MkLJensen/iFollow/RapportBilag/Proces/Trello/Research.PNG

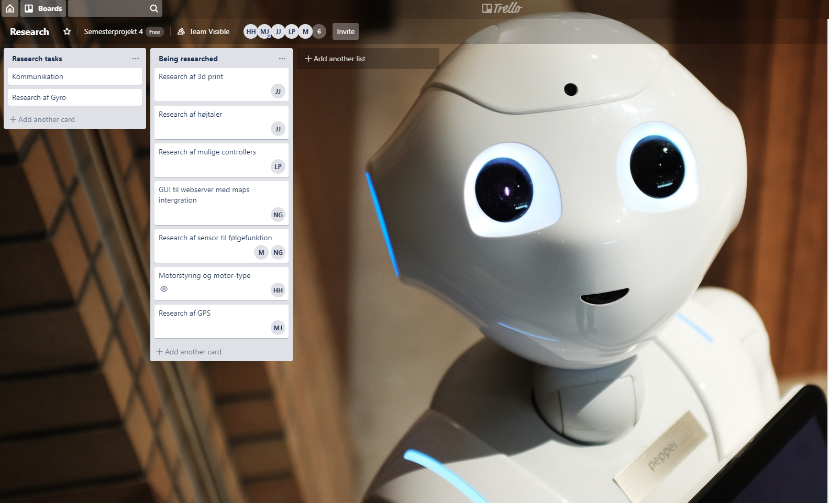
RapportBilag/Proces/Trello/Research.PNG
