MkLJensen/iFollow/RapportBilag/Proces/Trello/Sprint3.PNG

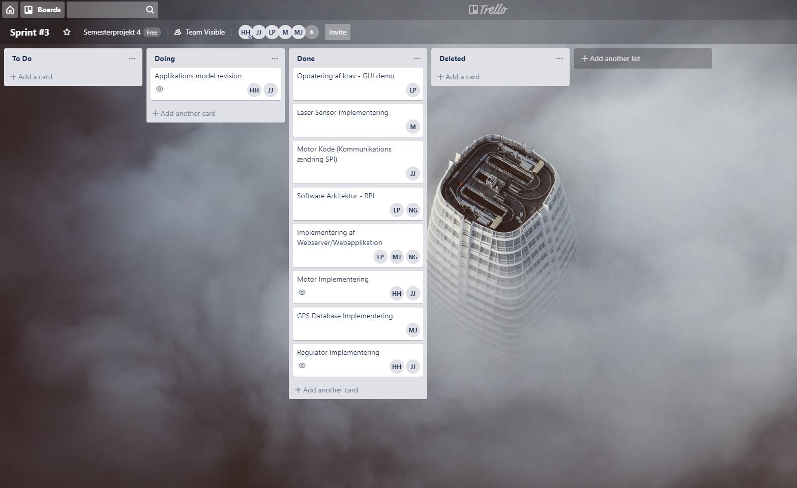
RapportBilag/Proces/Trello/Sprint3.PNG
