MkLJensen/iFollow/README.md

# iFollow - the spiciest memelord of a robot
