MkLJensen/iFollow/Krav og Design/Rigt Billede.pptx

Semesterprojekt 4 - iFollow

Interface

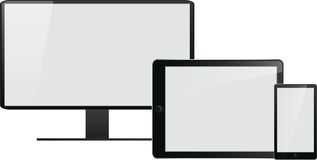
[picture p3: figure]
Billedresultat for pc / mobile

Web – Server (Wi-Fi)

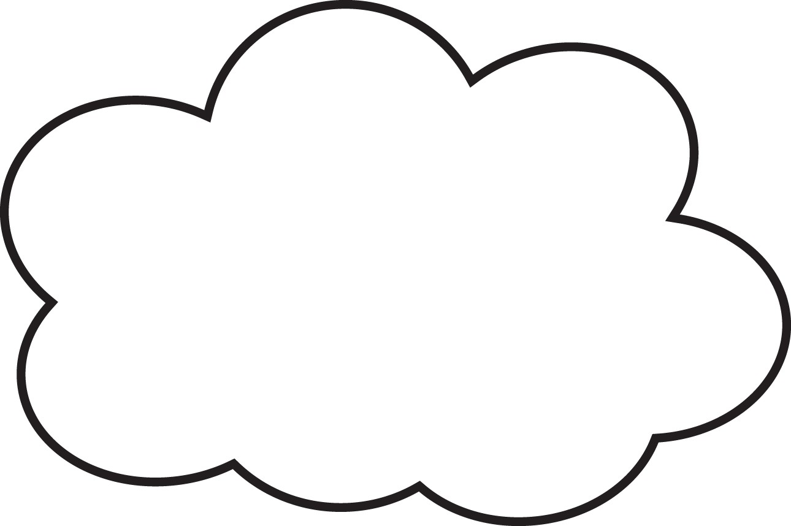
[picture p4: figure]
Billedresultat for cloud sketch

Communicating With

Wi-Fi

RPi

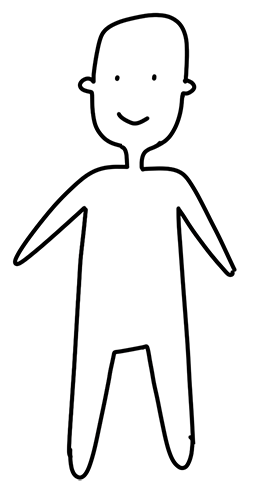
[picture p5: figure]
Billedresultat for person sketch

User

Interacts
with

Follow

Microcontroller

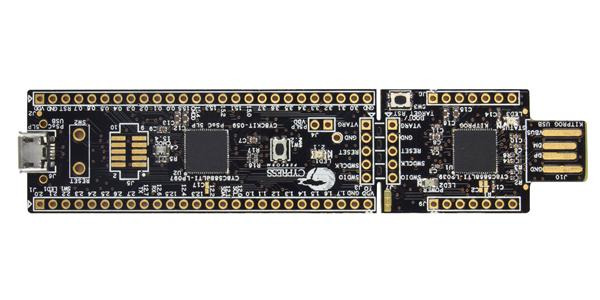
[picture p6: figure]
Billedresultat for psoc 5
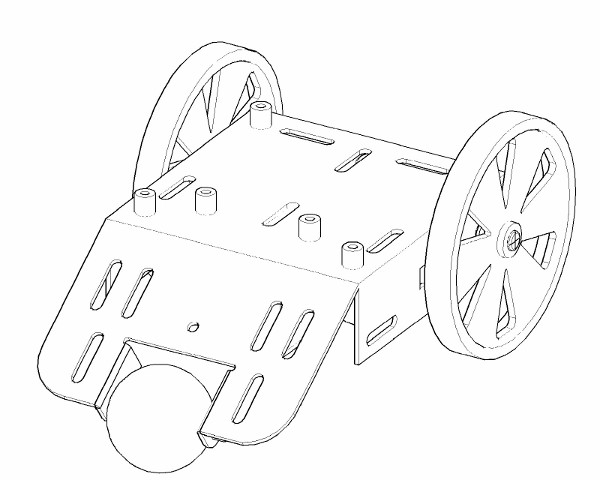
[picture p7: figure]
Billedresultat for 3 wheel robot drawing

Robot

Controlled by

Using

Controlling

Using

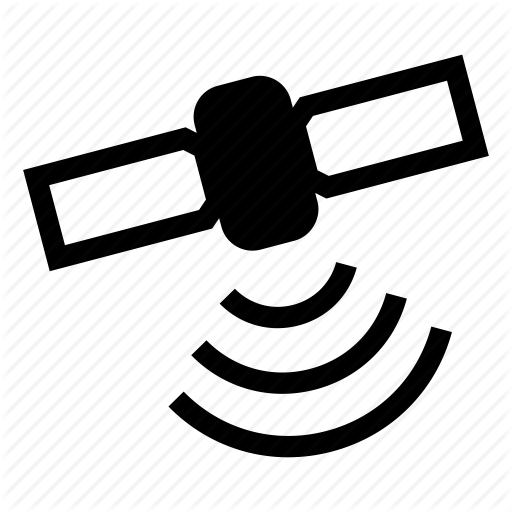
[picture p8: figure]
Billedresultat for gps icon transparent

GPS

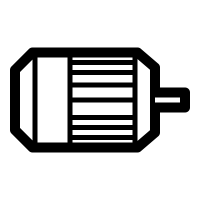
[picture p9: figure]
Billedresultat for motor icon

Motor

Sensor

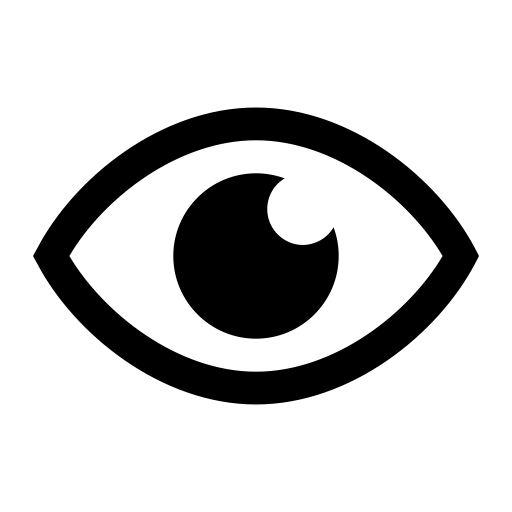
[picture p10: figure]
Billedresultat for eye icon
