MkLJensen/iFollow/Software/PSOC/ToF/Design01.cydsn/Design01_timing.html

# Static Timing Analysis

Project : | Design01
Build Time : | 05/01/19 14:06:55
Device : | CY8C5888LTI-LP097
Temperature : | -40C - 85/125C
VDDA : | 5.00
VDDABUF : | 5.00
VDDD : | 5.00
VDDIO0 : | 5.00
VDDIO1 : | 5.00
VDDIO2 : | 5.00
VDDIO3 : | 5.00
VUSB : | 5.00
Voltage : | 5.0

Expand All | Collapse All | Show All Paths | Hide All Paths

+ Timing Violation Section

No Timing Violations

+ Clock Summary Section

Clock | Domain | Nominal Frequency | Required Frequency | Maximum Frequency | Violation
CyILO | CyILO | 1.000 kHz | 1.000 kHz | N/A
CyIMO | CyIMO | 3.000 MHz | 3.000 MHz | N/A
CyMASTER_CLK | CyMASTER_CLK | 24.000 MHz | 24.000 MHz | N/A
CyBUS_CLK | CyMASTER_CLK | 24.000 MHz | 24.000 MHz | 61.725 MHz
SPIS_IntClock | CyMASTER_CLK | 4.000 MHz | 4.000 MHz | 63.167 MHz
UART_1_IntClock | CyMASTER_CLK | 461.538 kHz | 461.538 kHz | 45.043 MHz
CyPLL_OUT | CyPLL_OUT | 24.000 MHz | 24.000 MHz | N/A
sclk(0)_PAD | sclk(0)_PAD | UNKNOWN | UNKNOWN | 46.079 MHz

+ Register to Register Section

+ Setup Subsection

+ Source Clock : CyBUS_CLK : Positive edge(Required Frequency 24 MHz)

+ Destination Clock : UART_1_IntClock : Positive edge(Required Frequency 461.538 kHz)

Path Delay Requirement : 41.6667ns(24 MHz)

Affects clock : CyMASTER_CLK

Source | Destination | FMax | Delay (ns) | Slack (ns) | Violation
Rx_1(0)/fb | \UART_1:BUART:sRX:RxShifter:u0\/route_si | 61.725 MHz | 16.201 | 25.466

Type | Location | Fanout | Instance/Net | Source | Dest | Delay (ns)
iocell6 | P12[6] | 1 | Rx_1(0) | Rx_1(0)/in_clock | Rx_1(0)/fb | 2.009
Route | | 1 | Net_39 | Rx_1(0)/fb | \UART_1:BUART:rx_postpoll\/main_1 | 5.123
macrocell15 | U(0,0) | 1 | \UART_1:BUART:rx_postpoll\ | \UART_1:BUART:rx_postpoll\/main_1 | \UART_1:BUART:rx_postpoll\/q | 3.350
Route | | 1 | \UART_1:BUART:rx_postpoll\ | \UART_1:BUART:rx_postpoll\/q | \UART_1:BUART:sRX:RxShifter:u0\/route_si | 2.249
datapathcell4 | U(0,0) | 1 | \UART_1:BUART:sRX:RxShifter:u0\ | | SETUP | 3.470
Clock | | | | | Skew | 0.000
Rx_1(0)/fb | \UART_1:BUART:pollcount_1\/main_3 | 76.899 MHz | 13.004 | 28.663

Type | Location | Fanout | Instance/Net | Source | Dest | Delay (ns)
iocell6 | P12[6] | 1 | Rx_1(0) | Rx_1(0)/in_clock | Rx_1(0)/fb | 2.009
Route | | 1 | Net_39 | Rx_1(0)/fb | \UART_1:BUART:pollcount_1\/main_3 | 7.485
macrocell33 | U(0,1) | 1 | \UART_1:BUART:pollcount_1\ | | SETUP | 3.510
Clock | | | | | Skew | 0.000
Rx_1(0)/fb | \UART_1:BUART:pollcount_0\/main_2 | 80.308 MHz | 12.452 | 29.215

Type | Location | Fanout | Instance/Net | Source | Dest | Delay (ns)
iocell6 | P12[6] | 1 | Rx_1(0) | Rx_1(0)/in_clock | Rx_1(0)/fb | 2.009
Route | | 1 | Net_39 | Rx_1(0)/fb | \UART_1:BUART:pollcount_0\/main_2 | 6.933
macrocell34 | U(0,1) | 1 | \UART_1:BUART:pollcount_0\ | | SETUP | 3.510
Clock | | | | | Skew | 0.000
Rx_1(0)/fb | \UART_1:BUART:rx_state_2\/main_8 | 93.870 MHz | 10.653 | 31.014

Type | Location | Fanout | Instance/Net | Source | Dest | Delay (ns)
iocell6 | P12[6] | 1 | Rx_1(0) | Rx_1(0)/in_clock | Rx_1(0)/fb | 2.009
Route | | 1 | Net_39 | Rx_1(0)/fb | \UART_1:BUART:rx_state_2\/main_8 | 5.134
macrocell30 | U(0,0) | 1 | \UART_1:BUART:rx_state_2\ | | SETUP | 3.510
Clock | | | | | Skew | 0.000
Rx_1(0)/fb | \UART_1:BUART:rx_status_3\/main_6 | 93.870 MHz | 10.653 | 31.014

Type | Location | Fanout | Instance/Net | Source | Dest | Delay (ns)
iocell6 | P12[6] | 1 | Rx_1(0) | Rx_1(0)/in_clock | Rx_1(0)/fb | 2.009
Route | | 1 | Net_39 | Rx_1(0)/fb | \UART_1:BUART:rx_status_3\/main_6 | 5.134
macrocell35 | U(0,0) | 1 | \UART_1:BUART:rx_status_3\ | | SETUP | 3.510
Clock | | | | | Skew | 0.000
Rx_1(0)/fb | \UART_1:BUART:rx_state_0\/main_9 | 93.967 MHz | 10.642 | 31.025

Type | Location | Fanout | Instance/Net | Source | Dest | Delay (ns)
iocell6 | P12[6] | 1 | Rx_1(0) | Rx_1(0)/in_clock | Rx_1(0)/fb | 2.009
Route | | 1 | Net_39 | Rx_1(0)/fb | \UART_1:BUART:rx_state_0\/main_9 | 5.123
macrocell27 | U(0,0) | 1 | \UART_1:BUART:rx_state_0\ | | SETUP | 3.510
Clock | | | | | Skew | 0.000
Rx_1(0)/fb | \UART_1:BUART:rx_last\/main_0 | 93.967 MHz | 10.642 | 31.025

Type | Location | Fanout | Instance/Net | Source | Dest | Delay (ns)
iocell6 | P12[6] | 1 | Rx_1(0) | Rx_1(0)/in_clock | Rx_1(0)/fb | 2.009
Route | | 1 | Net_39 | Rx_1(0)/fb | \UART_1:BUART:rx_last\/main_0 | 5.123
macrocell36 | U(0,0) | 1 | \UART_1:BUART:rx_last\ | | SETUP | 3.510
Clock | | | | | Skew | 0.000

+ Source Clock : SPIS_IntClock : Positive edge(Required Frequency 4 MHz)

+ Destination Clock : SPIS_IntClock : Positive edge(Required Frequency 4 MHz)

Path Delay Requirement : 250ns(4 MHz)

Source | Destination | FMax | Delay (ns) | Slack (ns) | Violation
\SPIS:BSPIS:sync_2\/out | \SPIS:BSPIS:TxStsReg\/status_0 | 63.167 MHz | 15.831 | 234.169

Type | Location | Fanout | Instance/Net | Source | Dest | Delay (ns)
synccell | U(1,0) | 1 | \SPIS:BSPIS:sync_2\ | \SPIS:BSPIS:sync_2\/clock | \SPIS:BSPIS:sync_2\/out | 1.020
Route | | 1 | \SPIS:BSPIS:miso_tx_empty_reg_fin\ | \SPIS:BSPIS:sync_2\/out | \SPIS:BSPIS:tx_status_0\/main_2 | 5.713
macrocell7 | U(1,3) | 1 | \SPIS:BSPIS:tx_status_0\ | \SPIS:BSPIS:tx_status_0\/main_2 | \SPIS:BSPIS:tx_status_0\/q | 3.350
Route | | 1 | \SPIS:BSPIS:tx_status_0\ | \SPIS:BSPIS:tx_status_0\/q | \SPIS:BSPIS:TxStsReg\/status_0 | 5.248
statusicell1 | U(1,1) | 1 | \SPIS:BSPIS:TxStsReg\ | | SETUP | 0.500
Clock | | | | | Skew | 0.000
\SPIS:BSPIS:dpcounter_one_reg\/q | \SPIS:BSPIS:TxStsReg\/status_0 | 68.101 MHz | 14.684 | 235.316

Type | Location | Fanout | Instance/Net | Source | Dest | Delay (ns)
macrocell18 | U(1,0) | 1 | \SPIS:BSPIS:dpcounter_one_reg\ | \SPIS:BSPIS:dpcounter_one_reg\/clock_0 | \SPIS:BSPIS:dpcounter_one_reg\/q | 1.250
Route | | 1 | \SPIS:BSPIS:dpcounter_one_reg\ | \SPIS:BSPIS:dpcounter_one_reg\/q | \SPIS:BSPIS:tx_status_0\/main_1 | 4.336
macrocell7 | U(1,3) | 1 | \SPIS:BSPIS:tx_status_0\ | \SPIS:BSPIS:tx_status_0\/main_1 | \SPIS:BSPIS:tx_status_0\/q | 3.350
Route | | 1 | \SPIS:BSPIS:tx_status_0\ | \SPIS:BSPIS:tx_status_0\/q | \SPIS:BSPIS:TxStsReg\/status_0 | 5.248
statusicell1 | U(1,1) | 1 | \SPIS:BSPIS:TxStsReg\ | | SETUP | 0.500
Clock | | | | | Skew | 0.000
\SPIS:BSPIS:dpcounter_one_reg\/q | \SPIS:BSPIS:TxStsReg\/status_6 | 68.185 MHz | 14.666 | 235.334

Type | Location | Fanout | Instance/Net | Source | Dest | Delay (ns)
macrocell18 | U(1,0) | 1 | \SPIS:BSPIS:dpcounter_one_reg\ | \SPIS:BSPIS:dpcounter_one_reg\/clock_0 | \SPIS:BSPIS:dpcounter_one_reg\/q | 1.250
Route | | 1 | \SPIS:BSPIS:dpcounter_one_reg\ | \SPIS:BSPIS:dpcounter_one_reg\/q | \SPIS:BSPIS:byte_complete\/main_1 | 4.336
macrocell3 | U(1,3) | 1 | \SPIS:BSPIS:byte_complete\ | \SPIS:BSPIS:byte_complete\/main_1 | \SPIS:BSPIS:byte_complete\/q | 3.350
Route | | 1 | \SPIS:BSPIS:byte_complete\ | \SPIS:BSPIS:byte_complete\/q | \SPIS:BSPIS:TxStsReg\/status_6 | 5.230
statusicell1 | U(1,1) | 1 | \SPIS:BSPIS:TxStsReg\ | | SETUP | 0.500
Clock | | | | | Skew | 0.000
\SPIS:BSPIS:sync_1\/out | \SPIS:BSPIS:TxStsReg\/status_0 | 80.483 MHz | 12.425 | 237.575

Type | Location | Fanout | Instance/Net | Source | Dest | Delay (ns)
synccell | U(1,3) | 1 | \SPIS:BSPIS:sync_1\ | \SPIS:BSPIS:sync_1\/clock | \SPIS:BSPIS:sync_1\/out | 1.020
Route | | 1 | \SPIS:BSPIS:dpcounter_one_fin\ | \SPIS:BSPIS:sync_1\/out | \SPIS:BSPIS:tx_status_0\/main_0 | 2.307
macrocell7 | U(1,3) | 1 | \SPIS:BSPIS:tx_status_0\ | \SPIS:BSPIS:tx_status_0\/main_0 | \SPIS:BSPIS:tx_status_0\/q | 3.350
Route | | 1 | \SPIS:BSPIS:tx_status_0\ | \SPIS:BSPIS:tx_status_0\/q | \SPIS:BSPIS:TxStsReg\/status_0 | 5.248
statusicell1 | U(1,1) | 1 | \SPIS:BSPIS:TxStsReg\ | | SETUP | 0.500
Clock | | | | | Skew | 0.000
\SPIS:BSPIS:sync_1\/out | \SPIS:BSPIS:TxStsReg\/status_6 | 80.600 MHz | 12.407 | 237.593

Type | Location | Fanout | Instance/Net | Source | Dest | Delay (ns)
synccell | U(1,3) | 1 | \SPIS:BSPIS:sync_1\ | \SPIS:BSPIS:sync_1\/clock | \SPIS:BSPIS:sync_1\/out | 1.020
Route | | 1 | \SPIS:BSPIS:dpcounter_one_fin\ | \SPIS:BSPIS:sync_1\/out | \SPIS:BSPIS:byte_complete\/main_0 | 2.307
macrocell3 | U(1,3) | 1 | \SPIS:BSPIS:byte_complete\ | \SPIS:BSPIS:byte_complete\/main_0 | \SPIS:BSPIS:byte_complete\/q | 3.350
Route | | 1 | \SPIS:BSPIS:byte_complete\ | \SPIS:BSPIS:byte_complete\/q | \SPIS:BSPIS:TxStsReg\/status_6 | 5.230
statusicell1 | U(1,1) | 1 | \SPIS:BSPIS:TxStsReg\ | | SETUP | 0.500
Clock | | | | | Skew | 0.000
\SPIS:BSPIS:sync_3\/out | \SPIS:BSPIS:RxStsReg\/status_5 | 85.281 MHz | 11.726 | 238.274

Type | Location | Fanout | Instance/Net | Source | Dest | Delay (ns)
synccell | U(1,3) | 1 | \SPIS:BSPIS:sync_3\ | \SPIS:BSPIS:sync_3\/clock | \SPIS:BSPIS:sync_3\/out | 1.020
Route | | 1 | \SPIS:BSPIS:mosi_buf_overrun_reg\ | \SPIS:BSPIS:sync_3\/out | \SPIS:BSPIS:rx_buf_overrun\/main_0 | 4.535
macrocell4 | U(1,3) | 1 | \SPIS:BSPIS:rx_buf_overrun\ | \SPIS:BSPIS:rx_buf_overrun\/main_0 | \SPIS:BSPIS:rx_buf_overrun\/q | 3.350
Route | | 1 | \SPIS:BSPIS:rx_buf_overrun\ | \SPIS:BSPIS:rx_buf_overrun\/q | \SPIS:BSPIS:RxStsReg\/status_5 | 2.321
statusicell2 | U(0,3) | 1 | \SPIS:BSPIS:RxStsReg\ | | SETUP | 0.500
Clock | | | | | Skew | 0.000
\SPIS:BSPIS:mosi_buf_overrun_fin\/q | \SPIS:BSPIS:RxStsReg\/status_5 | 96.890 MHz | 10.321 | 239.679

Type | Location | Fanout | Instance/Net | Source | Dest | Delay (ns)
macrocell19 | U(1,2) | 1 | \SPIS:BSPIS:mosi_buf_overrun_fin\ | \SPIS:BSPIS:mosi_buf_overrun_fin\/clock_0 | \SPIS:BSPIS:mosi_buf_overrun_fin\/q | 1.250
Route | | 1 | \SPIS:BSPIS:mosi_buf_overrun_fin\ | \SPIS:BSPIS:mosi_buf_overrun_fin\/q | \SPIS:BSPIS:rx_buf_overrun\/main_1 | 2.900
macrocell4 | U(1,3) | 1 | \SPIS:BSPIS:rx_buf_overrun\ | \SPIS:BSPIS:rx_buf_overrun\/main_1 | \SPIS:BSPIS:rx_buf_overrun\/q | 3.350
Route | | 1 | \SPIS:BSPIS:rx_buf_overrun\ | \SPIS:BSPIS:rx_buf_overrun\/q | \SPIS:BSPIS:RxStsReg\/status_5 | 2.321
statusicell2 | U(0,3) | 1 | \SPIS:BSPIS:RxStsReg\ | | SETUP | 0.500
Clock | | | | | Skew | 0.000
\SPIS:BSPIS:sync_1\/out | \SPIS:BSPIS:dpcounter_one_reg\/main_0 | 108.401 MHz | 9.225 | 240.775

Type | Location | Fanout | Instance/Net | Source | Dest | Delay (ns)
synccell | U(1,3) | 1 | \SPIS:BSPIS:sync_1\ | \SPIS:BSPIS:sync_1\/clock | \SPIS:BSPIS:sync_1\/out | 1.020
Route | | 1 | \SPIS:BSPIS:dpcounter_one_fin\ | \SPIS:BSPIS:sync_1\/out | \SPIS:BSPIS:dpcounter_one_reg\/main_0 | 4.695
macrocell18 | U(1,0) | 1 | \SPIS:BSPIS:dpcounter_one_reg\ | | SETUP | 3.510
Clock | | | | | Skew | 0.000
\SPIS:BSPIS:sync_3\/out | \SPIS:BSPIS:mosi_buf_overrun_fin\/main_0 | 118.399 MHz | 8.446 | 241.554

Type | Location | Fanout | Instance/Net | Source | Dest | Delay (ns)
synccell | U(1,3) | 1 | \SPIS:BSPIS:sync_3\ | \SPIS:BSPIS:sync_3\/clock | \SPIS:BSPIS:sync_3\/out | 1.020
Route | | 1 | \SPIS:BSPIS:mosi_buf_overrun_reg\ | \SPIS:BSPIS:sync_3\/out | \SPIS:BSPIS:mosi_buf_overrun_fin\/main_0 | 3.916
macrocell19 | U(1,2) | 1 | \SPIS:BSPIS:mosi_buf_overrun_fin\ | | SETUP | 3.510
Clock | | | | | Skew | 0.000

+ Source Clock : UART_1_IntClock : Positive edge(Required Frequency 461.538 kHz)

+ Destination Clock : UART_1_IntClock : Positive edge(Required Frequency 461.538 kHz)

Path Delay Requirement : 2166.67ns(461.538 kHz)

Source | Destination | FMax | Delay (ns) | Slack (ns) | Violation
\UART_1:BUART:rx_state_0\/q | \UART_1:BUART:sRX:RxBitCounter\/load | 45.043 MHz | 22.201 | 2144.466

Type | Location | Fanout | Instance/Net | Source | Dest | Delay (ns)
macrocell27 | U(0,0) | 1 | \UART_1:BUART:rx_state_0\ | \UART_1:BUART:rx_state_0\/clock_0 | \UART_1:BUART:rx_state_0\/q | 1.250
Route | | 1 | \UART_1:BUART:rx_state_0\ | \UART_1:BUART:rx_state_0\/q | \UART_1:BUART:rx_counter_load\/main_1 | 7.882
macrocell14 | U(0,3) | 1 | \UART_1:BUART:rx_counter_load\ | \UART_1:BUART:rx_counter_load\/main_1 | \UART_1:BUART:rx_counter_load\/q | 3.350
Route | | 1 | \UART_1:BUART:rx_counter_load\ | \UART_1:BUART:rx_counter_load\/q | \UART_1:BUART:sRX:RxBitCounter\/load | 4.359
count7cell | U(0,0) | 1 | \UART_1:BUART:sRX:RxBitCounter\ | | SETUP | 5.360
Clock | | | | | Skew | 0.000
\UART_1:BUART:rx_state_2\/q | \UART_1:BUART:sRX:RxBitCounter\/load | 48.480 MHz | 20.627 | 2146.040

Type | Location | Fanout | Instance/Net | Source | Dest | Delay (ns)
macrocell30 | U(0,0) | 1 | \UART_1:BUART:rx_state_2\ | \UART_1:BUART:rx_state_2\/clock_0 | \UART_1:BUART:rx_state_2\/q | 1.250
Route | | 1 | \UART_1:BUART:rx_state_2\ | \UART_1:BUART:rx_state_2\/q | \UART_1:BUART:rx_counter_load\/main_3 | 6.308
macrocell14 | U(0,3) | 1 | \UART_1:BUART:rx_counter_load\ | \UART_1:BUART:rx_counter_load\/main_3 | \UART_1:BUART:rx_counter_load\/q | 3.350
Route | | 1 | \UART_1:BUART:rx_counter_load\ | \UART_1:BUART:rx_counter_load\/q | \UART_1:BUART:sRX:RxBitCounter\/load | 4.359
count7cell | U(0,0) | 1 | \UART_1:BUART:sRX:RxBitCounter\ | | SETUP | 5.360
Clock | | | | | Skew | 0.000
\UART_1:BUART:tx_ctrl_mark_last\/q | \UART_1:BUART:sRX:RxBitCounter\/load | 50.587 MHz | 19.768 | 2146.899

Type | Location | Fanout | Instance/Net | Source | Dest | Delay (ns)
macrocell26 | U(0,1) | 1 | \UART_1:BUART:tx_ctrl_mark_last\ | \UART_1:BUART:tx_ctrl_mark_last\/clock_0 | \UART_1:BUART:tx_ctrl_mark_last\/q | 1.250
Route | | 1 | \UART_1:BUART:tx_ctrl_mark_last\ | \UART_1:BUART:tx_ctrl_mark_last\/q | \UART_1:BUART:rx_counter_load\/main_0 | 5.449
macrocell14 | U(0,3) | 1 | \UART_1:BUART:rx_counter_load\ | \UART_1:BUART:rx_counter_load\/main_0 | \UART_1:BUART:rx_counter_load\/q | 3.350
Route | | 1 | \UART_1:BUART:rx_counter_load\ | \UART_1:BUART:rx_counter_load\/q | \UART_1:BUART:sRX:RxBitCounter\/load | 4.359
count7cell | U(0,0) | 1 | \UART_1:BUART:sRX:RxBitCounter\ | | SETUP | 5.360
Clock | | | | | Skew | 0.000
\UART_1:BUART:sTX:TxShifter:u0\/f0_blk_stat_comb | \UART_1:BUART:sTX:TxSts\/status_0 | 53.772 MHz | 18.597 | 2148.070

Type | Location | Fanout | Instance/Net | Source | Dest | Delay (ns)
datapathcell2 | U(0,3) | 1 | \UART_1:BUART:sTX:TxShifter:u0\ | \UART_1:BUART:sTX:TxShifter:u0\/clock | \UART_1:BUART:sTX:TxShifter:u0\/f0_blk_stat_comb | 3.580
Route | | 1 | \UART_1:BUART:tx_fifo_empty\ | \UART_1:BUART:sTX:TxShifter:u0\/f0_blk_stat_comb | \UART_1:BUART:tx_status_0\/main_3 | 5.342
macrocell12 | U(0,1) | 1 | \UART_1:BUART:tx_status_0\ | \UART_1:BUART:tx_status_0\/main_3 | \UART_1:BUART:tx_status_0\/q | 3.350
Route | | 1 | \UART_1:BUART:tx_status_0\ | \UART_1:BUART:tx_status_0\/q | \UART_1:BUART:sTX:TxSts\/status_0 | 5.825
statusicell3 | U(0,2) | 1 | \UART_1:BUART:sTX:TxSts\ | | SETUP | 0.500
Clock | | | | | Skew | 0.000
\UART_1:BUART:rx_state_3\/q | \UART_1:BUART:sRX:RxBitCounter\/load | 54.431 MHz | 18.372 | 2148.295

Type | Location | Fanout | Instance/Net | Source | Dest | Delay (ns)
macrocell29 | U(1,3) | 1 | \UART_1:BUART:rx_state_3\ | \UART_1:BUART:rx_state_3\/clock_0 | \UART_1:BUART:rx_state_3\/q | 1.250
Route | | 1 | \UART_1:BUART:rx_state_3\ | \UART_1:BUART:rx_state_3\/q | \UART_1:BUART:rx_counter_load\/main_2 | 4.053
macrocell14 | U(0,3) | 1 | \UART_1:BUART:rx_counter_load\ | \UART_1:BUART:rx_counter_load\/main_2 | \UART_1:BUART:rx_counter_load\/q | 3.350
Route | | 1 | \UART_1:BUART:rx_counter_load\ | \UART_1:BUART:rx_counter_load\/q | \UART_1:BUART:sRX:RxBitCounter\/load | 4.359
count7cell | U(0,0) | 1 | \UART_1:BUART:sRX:RxBitCounter\ | | SETUP | 5.360
Clock | | | | | Skew | 0.000
\UART_1:BUART:tx_state_2\/q | \UART_1:BUART:sTX:sCLOCK:TxBitClkGen\/cs_addr_0 | 57.333 MHz | 17.442 | 2149.225

Type | Location | Fanout | Instance/Net | Source | Dest | Delay (ns)
macrocell24 | U(0,1) | 1 | \UART_1:BUART:tx_state_2\ | \UART_1:BUART:tx_state_2\/clock_0 | \UART_1:BUART:tx_state_2\/q | 1.250
Route | | 1 | \UART_1:BUART:tx_state_2\ | \UART_1:BUART:tx_state_2\/q | \UART_1:BUART:counter_load_not\/main_3 | 4.358
macrocell11 | U(0,2) | 1 | \UART_1:BUART:counter_load_not\ | \UART_1:BUART:counter_load_not\/main_3 | \UART_1:BUART:counter_load_not\/q | 3.350
Route | | 1 | \UART_1:BUART:counter_load_not\ | \UART_1:BUART:counter_load_not\/q | \UART_1:BUART:sTX:sCLOCK:TxBitClkGen\/cs_addr_0 | 2.294
datapathcell3 | U(0,2) | 1 | \UART_1:BUART:sTX:sCLOCK:TxBitClkGen\ | | SETUP | 6.190
Clock | | | | | Skew | 0.000
\UART_1:BUART:tx_state_0\/q | \UART_1:BUART:sTX:sCLOCK:TxBitClkGen\/cs_addr_0 | 59.147 MHz | 16.907 | 2149.760

Type | Location | Fanout | Instance/Net | Source | Dest | Delay (ns)
macrocell23 | U(0,2) | 1 | \UART_1:BUART:tx_state_0\ | \UART_1:BUART:tx_state_0\/clock_0 | \UART_1:BUART:tx_state_0\/q | 1.250
Route | | 1 | \UART_1:BUART:tx_state_0\ | \UART_1:BUART:tx_state_0\/q | \UART_1:BUART:counter_load_not\/main_1 | 3.823
macrocell11 | U(0,2) | 1 | \UART_1:BUART:counter_load_not\ | \UART_1:BUART:counter_load_not\/main_1 | \UART_1:BUART:counter_load_not\/q | 3.350
Route | | 1 | \UART_1:BUART:counter_load_not\ | \UART_1:BUART:counter_load_not\/q | \UART_1:BUART:sTX:sCLOCK:TxBitClkGen\/cs_addr_0 | 2.294
datapathcell3 | U(0,2) | 1 | \UART_1:BUART:sTX:sCLOCK:TxBitClkGen\ | | SETUP | 6.190
Clock | | | | | Skew | 0.000
\UART_1:BUART:tx_state_1\/q | \UART_1:BUART:sTX:sCLOCK:TxBitClkGen\/cs_addr_0 | 59.701 MHz | 16.750 | 2149.917

Type | Location | Fanout | Instance/Net | Source | Dest | Delay (ns)
macrocell22 | U(0,2) | 1 | \UART_1:BUART:tx_state_1\ | \UART_1:BUART:tx_state_1\/clock_0 | \UART_1:BUART:tx_state_1\/q | 1.250
Route | | 1 | \UART_1:BUART:tx_state_1\ | \UART_1:BUART:tx_state_1\/q | \UART_1:BUART:counter_load_not\/main_0 | 3.666
macrocell11 | U(0,2) | 1 | \UART_1:BUART:counter_load_not\ | \UART_1:BUART:counter_load_not\/main_0 | \UART_1:BUART:counter_load_not\/q | 3.350
Route | | 1 | \UART_1:BUART:counter_load_not\ | \UART_1:BUART:counter_load_not\/q | \UART_1:BUART:sTX:sCLOCK:TxBitClkGen\/cs_addr_0 | 2.294
datapathcell3 | U(0,2) | 1 | \UART_1:BUART:sTX:sCLOCK:TxBitClkGen\ | | SETUP | 6.190
Clock | | | | | Skew | 0.000
\UART_1:BUART:sRX:RxShifter:u0\/f0_blk_stat_comb | \UART_1:BUART:sRX:RxSts\/status_4 | 60.190 MHz | 16.614 | 2150.053

Type | Location | Fanout | Instance/Net | Source | Dest | Delay (ns)
datapathcell4 | U(0,0) | 1 | \UART_1:BUART:sRX:RxShifter:u0\ | \UART_1:BUART:sRX:RxShifter:u0\/clock | \UART_1:BUART:sRX:RxShifter:u0\/f0_blk_stat_comb | 3.580
Route | | 1 | \UART_1:BUART:rx_fifofull\ | \UART_1:BUART:sRX:RxShifter:u0\/f0_blk_stat_comb | \UART_1:BUART:rx_status_4\/main_1 | 2.822
macrocell16 | U(1,1) | 1 | \UART_1:BUART:rx_status_4\ | \UART_1:BUART:rx_status_4\/main_1 | \UART_1:BUART:rx_status_4\/q | 3.350
Route | | 1 | \UART_1:BUART:rx_status_4\ | \UART_1:BUART:rx_status_4\/q | \UART_1:BUART:sRX:RxSts\/status_4 | 6.362
statusicell4 | U(1,2) | 1 | \UART_1:BUART:sRX:RxSts\ | | SETUP | 0.500
Clock | | | | | Skew | 0.000
\UART_1:BUART:tx_state_0\/q | \UART_1:BUART:sTX:TxSts\/status_0 | 62.170 MHz | 16.085 | 2150.582

Type | Location | Fanout | Instance/Net | Source | Dest | Delay (ns)
macrocell23 | U(0,2) | 1 | \UART_1:BUART:tx_state_0\ | \UART_1:BUART:tx_state_0\/clock_0 | \UART_1:BUART:tx_state_0\/q | 1.250
Route | | 1 | \UART_1:BUART:tx_state_0\ | \UART_1:BUART:tx_state_0\/q | \UART_1:BUART:tx_status_0\/main_1 | 5.160
macrocell12 | U(0,1) | 1 | \UART_1:BUART:tx_status_0\ | \UART_1:BUART:tx_status_0\/main_1 | \UART_1:BUART:tx_status_0\/q | 3.350
Route | | 1 | \UART_1:BUART:tx_status_0\ | \UART_1:BUART:tx_status_0\/q | \UART_1:BUART:sTX:TxSts\/status_0 | 5.825
statusicell3 | U(0,2) | 1 | \UART_1:BUART:sTX:TxSts\ | | SETUP | 0.500
Clock | | | | | Skew | 0.000

+ Source Clock : sclk(0)_PAD : Positive edge

+ Destination Clock : sclk(0)_PAD : Negative edge

Path Delay Requirement : 5000ns

Source | Destination | FMax | Delay (ns) | Slack (ns) | Violation
\SPIS:BSPIS:mosi_tmp\/q | \SPIS:BSPIS:sR8:Dp:u0\/route_si | 92.157 MHz | 10.851

Type | Location | Fanout | Instance/Net | Source | Dest | Delay (ns)
macrocell20 | U(1,1) | 1 | \SPIS:BSPIS:mosi_tmp\ | \SPIS:BSPIS:mosi_tmp\/clock_0 | \SPIS:BSPIS:mosi_tmp\/q | 1.250
Route | | 1 | \SPIS:BSPIS:mosi_tmp\ | \SPIS:BSPIS:mosi_tmp\/q | \SPIS:BSPIS:mosi_to_dp\/main_5 | 2.285
macrocell9 | U(1,1) | 1 | \SPIS:BSPIS:mosi_to_dp\ | \SPIS:BSPIS:mosi_to_dp\/main_5 | \SPIS:BSPIS:mosi_to_dp\/q | 3.350
Route | | 1 | \SPIS:BSPIS:mosi_to_dp\ | \SPIS:BSPIS:mosi_to_dp\/q | \SPIS:BSPIS:sR8:Dp:u0\/route_si | 2.924
datapathcell1 | U(1,2) | 1 | \SPIS:BSPIS:sR8:Dp:u0\ | | SETUP | 1.970
Clock | | | | | Skew | -0.928

+ Source Clock : sclk(0)_PAD : Negative edge

+ Destination Clock : sclk(0)_PAD : Positive edge

Path Delay Requirement : 5000ns

Source | Destination | FMax | Delay (ns) | Slack (ns) | Violation
\SPIS:BSPIS:BitCounter\/count_1 | \SPIS:BSPIS:sR8:Dp:u0\/f1_load | 99.305 MHz | 10.070

Type | Location | Fanout | Instance/Net | Source | Dest | Delay (ns)
count7cell | U(0,1) | 1 | \SPIS:BSPIS:BitCounter\ | \SPIS:BSPIS:BitCounter\/clock_n | \SPIS:BSPIS:BitCounter\/count_1 | 1.940
Route | | 1 | \SPIS:BSPIS:count_1\ | \SPIS:BSPIS:BitCounter\/count_1 | \SPIS:BSPIS:tx_load\/main_2 | 3.387
macrocell2 | U(1,2) | 1 | \SPIS:BSPIS:tx_load\ | \SPIS:BSPIS:tx_load\/main_2 | \SPIS:BSPIS:tx_load\/q | 3.350
Route | | 1 | \SPIS:BSPIS:tx_load\ | \SPIS:BSPIS:tx_load\/q | \SPIS:BSPIS:sR8:Dp:u0\/f1_load | 2.320
datapathcell1 | U(1,2) | 1 | \SPIS:BSPIS:sR8:Dp:u0\ | | SETUP | -0.000
Clock | | | | | Skew | -0.927
\SPIS:BSPIS:BitCounter\/count_2 | \SPIS:BSPIS:sR8:Dp:u0\/f1_load | 99.374 MHz | 10.063

Type | Location | Fanout | Instance/Net | Source | Dest | Delay (ns)
count7cell | U(0,1) | 1 | \SPIS:BSPIS:BitCounter\ | \SPIS:BSPIS:BitCounter\/clock_n | \SPIS:BSPIS:BitCounter\/count_2 | 1.940
Route | | 1 | \SPIS:BSPIS:count_2\ | \SPIS:BSPIS:BitCounter\/count_2 | \SPIS:BSPIS:tx_load\/main_1 | 3.380
macrocell2 | U(1,2) | 1 | \SPIS:BSPIS:tx_load\ | \SPIS:BSPIS:tx_load\/main_1 | \SPIS:BSPIS:tx_load\/q | 3.350
Route | | 1 | \SPIS:BSPIS:tx_load\ | \SPIS:BSPIS:tx_load\/q | \SPIS:BSPIS:sR8:Dp:u0\/f1_load | 2.320
datapathcell1 | U(1,2) | 1 | \SPIS:BSPIS:sR8:Dp:u0\ | | SETUP | -0.000
Clock | | | | | Skew | -0.927
\SPIS:BSPIS:BitCounter\/count_3 | \SPIS:BSPIS:sR8:Dp:u0\/f1_load | 101.235 MHz | 9.878

Type | Location | Fanout | Instance/Net | Source | Dest | Delay (ns)
count7cell | U(0,1) | 1 | \SPIS:BSPIS:BitCounter\ | \SPIS:BSPIS:BitCounter\/clock_n | \SPIS:BSPIS:BitCounter\/count_3 | 1.940
Route | | 1 | \SPIS:BSPIS:count_3\ | \SPIS:BSPIS:BitCounter\/count_3 | \SPIS:BSPIS:tx_load\/main_0 | 3.195
macrocell2 | U(1,2) | 1 | \SPIS:BSPIS:tx_load\ | \SPIS:BSPIS:tx_load\/main_0 | \SPIS:BSPIS:tx_load\/q | 3.350
Route | | 1 | \SPIS:BSPIS:tx_load\ | \SPIS:BSPIS:tx_load\/q | \SPIS:BSPIS:sR8:Dp:u0\/f1_load | 2.320
datapathcell1 | U(1,2) | 1 | \SPIS:BSPIS:sR8:Dp:u0\ | | SETUP | -0.000
Clock | | | | | Skew | -0.927
\SPIS:BSPIS:BitCounter\/count_0 | \SPIS:BSPIS:sR8:Dp:u0\/f1_load | 101.245 MHz | 9.877

Type | Location | Fanout | Instance/Net | Source | Dest | Delay (ns)
count7cell | U(0,1) | 1 | \SPIS:BSPIS:BitCounter\ | \SPIS:BSPIS:BitCounter\/clock_n | \SPIS:BSPIS:BitCounter\/count_0 | 1.940
Route | | 1 | \SPIS:BSPIS:count_0\ | \SPIS:BSPIS:BitCounter\/count_0 | \SPIS:BSPIS:tx_load\/main_3 | 3.194
macrocell2 | U(1,2) | 1 | \SPIS:BSPIS:tx_load\ | \SPIS:BSPIS:tx_load\/main_3 | \SPIS:BSPIS:tx_load\/q | 3.350
Route | | 1 | \SPIS:BSPIS:tx_load\ | \SPIS:BSPIS:tx_load\/q | \SPIS:BSPIS:sR8:Dp:u0\/f1_load | 2.320
datapathcell1 | U(1,2) | 1 | \SPIS:BSPIS:sR8:Dp:u0\ | | SETUP | -0.000
Clock | | | | | Skew | -0.927

+ Destination Clock : sclk(0)_PAD : Negative edge

Path Delay Requirement : 10000ns

Source | Destination | FMax | Delay (ns) | Slack (ns) | Violation
\SPIS:BSPIS:BitCounter\/count_1 | \SPIS:BSPIS:sR8:Dp:u0\/cs_addr_0 | 68.729 MHz | 14.550

Type | Location | Fanout | Instance/Net | Source | Dest | Delay (ns)
count7cell | U(0,1) | 1 | \SPIS:BSPIS:BitCounter\ | \SPIS:BSPIS:BitCounter\/clock_n | \SPIS:BSPIS:BitCounter\/count_1 | 1.940
Route | | 1 | \SPIS:BSPIS:count_1\ | \SPIS:BSPIS:BitCounter\/count_1 | \SPIS:BSPIS:tx_load\/main_2 | 3.387
macrocell2 | U(1,2) | 1 | \SPIS:BSPIS:tx_load\ | \SPIS:BSPIS:tx_load\/main_2 | \SPIS:BSPIS:tx_load\/q | 3.350
Route | | 1 | \SPIS:BSPIS:tx_load\ | \SPIS:BSPIS:tx_load\/q | \SPIS:BSPIS:sR8:Dp:u0\/cs_addr_0 | 2.320
datapathcell1 | U(1,2) | 1 | \SPIS:BSPIS:sR8:Dp:u0\ | | SETUP | 4.480
Clock | | | | | Skew | -0.927
\SPIS:BSPIS:BitCounter\/count_2 | \SPIS:BSPIS:sR8:Dp:u0\/cs_addr_0 | 68.762 MHz | 14.543

Type | Location | Fanout | Instance/Net | Source | Dest | Delay (ns)
count7cell | U(0,1) | 1 | \SPIS:BSPIS:BitCounter\ | \SPIS:BSPIS:BitCounter\/clock_n | \SPIS:BSPIS:BitCounter\/count_2 | 1.940
Route | | 1 | \SPIS:BSPIS:count_2\ | \SPIS:BSPIS:BitCounter\/count_2 | \SPIS:BSPIS:tx_load\/main_1 | 3.380
macrocell2 | U(1,2) | 1 | \SPIS:BSPIS:tx_load\ | \SPIS:BSPIS:tx_load\/main_1 | \SPIS:BSPIS:tx_load\/q | 3.350
Route | | 1 | \SPIS:BSPIS:tx_load\ | \SPIS:BSPIS:tx_load\/q | \SPIS:BSPIS:sR8:Dp:u0\/cs_addr_0 | 2.320
datapathcell1 | U(1,2) | 1 | \SPIS:BSPIS:sR8:Dp:u0\ | | SETUP | 4.480
Clock | | | | | Skew | -0.927
\SPIS:BSPIS:BitCounter\/count_3 | \SPIS:BSPIS:sR8:Dp:u0\/cs_addr_0 | 69.648 MHz | 14.358

Type | Location | Fanout | Instance/Net | Source | Dest | Delay (ns)
count7cell | U(0,1) | 1 | \SPIS:BSPIS:BitCounter\ | \SPIS:BSPIS:BitCounter\/clock_n | \SPIS:BSPIS:BitCounter\/count_3 | 1.940
Route | | 1 | \SPIS:BSPIS:count_3\ | \SPIS:BSPIS:BitCounter\/count_3 | \SPIS:BSPIS:tx_load\/main_0 | 3.195
macrocell2 | U(1,2) | 1 | \SPIS:BSPIS:tx_load\ | \SPIS:BSPIS:tx_load\/main_0 | \SPIS:BSPIS:tx_load\/q | 3.350
Route | | 1 | \SPIS:BSPIS:tx_load\ | \SPIS:BSPIS:tx_load\/q | \SPIS:BSPIS:sR8:Dp:u0\/cs_addr_0 | 2.320
datapathcell1 | U(1,2) | 1 | \SPIS:BSPIS:sR8:Dp:u0\ | | SETUP | 4.480
Clock | | | | | Skew | -0.927
\SPIS:BSPIS:BitCounter\/count_0 | \SPIS:BSPIS:sR8:Dp:u0\/cs_addr_0 | 69.652 MHz | 14.357

Type | Location | Fanout | Instance/Net | Source | Dest | Delay (ns)
count7cell | U(0,1) | 1 | \SPIS:BSPIS:BitCounter\ | \SPIS:BSPIS:BitCounter\/clock_n | \SPIS:BSPIS:BitCounter\/count_0 | 1.940
Route | | 1 | \SPIS:BSPIS:count_0\ | \SPIS:BSPIS:BitCounter\/count_0 | \SPIS:BSPIS:tx_load\/main_3 | 3.194
macrocell2 | U(1,2) | 1 | \SPIS:BSPIS:tx_load\ | \SPIS:BSPIS:tx_load\/main_3 | \SPIS:BSPIS:tx_load\/q | 3.350
Route | | 1 | \SPIS:BSPIS:tx_load\ | \SPIS:BSPIS:tx_load\/q | \SPIS:BSPIS:sR8:Dp:u0\/cs_addr_0 | 2.320
datapathcell1 | U(1,2) | 1 | \SPIS:BSPIS:sR8:Dp:u0\ | | SETUP | 4.480
Clock | | | | | Skew | -0.927
\SPIS:BSPIS:BitCounter\/count_1 | \SPIS:BSPIS:sR8:Dp:u0\/route_si | 83.879 MHz | 11.922

Type | Location | Fanout | Instance/Net | Source | Dest | Delay (ns)
count7cell | U(0,1) | 1 | \SPIS:BSPIS:BitCounter\ | \SPIS:BSPIS:BitCounter\/clock_n | \SPIS:BSPIS:BitCounter\/count_1 | 1.940
Route | | 1 | \SPIS:BSPIS:count_1\ | \SPIS:BSPIS:BitCounter\/count_1 | \SPIS:BSPIS:mosi_to_dp\/main_3 | 2.665
macrocell9 | U(1,1) | 1 | \SPIS:BSPIS:mosi_to_dp\ | \SPIS:BSPIS:mosi_to_dp\/main_3 | \SPIS:BSPIS:mosi_to_dp\/q | 3.350
Route | | 1 | \SPIS:BSPIS:mosi_to_dp\ | \SPIS:BSPIS:mosi_to_dp\/q | \SPIS:BSPIS:sR8:Dp:u0\/route_si | 2.924
datapathcell1 | U(1,2) | 1 | \SPIS:BSPIS:sR8:Dp:u0\ | | SETUP | 1.970
Clock | | | | | Skew | -0.927
\SPIS:BSPIS:BitCounter\/count_2 | \SPIS:BSPIS:sR8:Dp:u0\/route_si | 83.991 MHz | 11.906

Type | Location | Fanout | Instance/Net | Source | Dest | Delay (ns)
count7cell | U(0,1) | 1 | \SPIS:BSPIS:BitCounter\ | \SPIS:BSPIS:BitCounter\/clock_n | \SPIS:BSPIS:BitCounter\/count_2 | 1.940
Route | | 1 | \SPIS:BSPIS:count_2\ | \SPIS:BSPIS:BitCounter\/count_2 | \SPIS:BSPIS:mosi_to_dp\/main_2 | 2.649
macrocell9 | U(1,1) | 1 | \SPIS:BSPIS:mosi_to_dp\ | \SPIS:BSPIS:mosi_to_dp\/main_2 | \SPIS:BSPIS:mosi_to_dp\/q | 3.350
Route | | 1 | \SPIS:BSPIS:mosi_to_dp\ | \SPIS:BSPIS:mosi_to_dp\/q | \SPIS:BSPIS:sR8:Dp:u0\/route_si | 2.924
datapathcell1 | U(1,2) | 1 | \SPIS:BSPIS:sR8:Dp:u0\ | | SETUP | 1.970
Clock | | | | | Skew | -0.927
\SPIS:BSPIS:BitCounter\/count_3 | \SPIS:BSPIS:sR8:Dp:u0\/route_si | 86.244 MHz | 11.595

Type | Location | Fanout | Instance/Net | Source | Dest | Delay (ns)
count7cell | U(0,1) | 1 | \SPIS:BSPIS:BitCounter\ | \SPIS:BSPIS:BitCounter\/clock_n | \SPIS:BSPIS:BitCounter\/count_3 | 1.940
Route | | 1 | \SPIS:BSPIS:count_3\ | \SPIS:BSPIS:BitCounter\/count_3 | \SPIS:BSPIS:mosi_to_dp\/main_1 | 2.338
macrocell9 | U(1,1) | 1 | \SPIS:BSPIS:mosi_to_dp\ | \SPIS:BSPIS:mosi_to_dp\/main_1 | \SPIS:BSPIS:mosi_to_dp\/q | 3.350
Route | | 1 | \SPIS:BSPIS:mosi_to_dp\ | \SPIS:BSPIS:mosi_to_dp\/q | \SPIS:BSPIS:sR8:Dp:u0\/route_si | 2.924
datapathcell1 | U(1,2) | 1 | \SPIS:BSPIS:sR8:Dp:u0\ | | SETUP | 1.970
Clock | | | | | Skew | -0.927
\SPIS:BSPIS:BitCounter\/count_0 | \SPIS:BSPIS:sR8:Dp:u0\/route_si | 86.266 MHz | 11.592

Type | Location | Fanout | Instance/Net | Source | Dest | Delay (ns)
count7cell | U(0,1) | 1 | \SPIS:BSPIS:BitCounter\ | \SPIS:BSPIS:BitCounter\/clock_n | \SPIS:BSPIS:BitCounter\/count_0 | 1.940
Route | | 1 | \SPIS:BSPIS:count_0\ | \SPIS:BSPIS:BitCounter\/count_0 | \SPIS:BSPIS:mosi_to_dp\/main_4 | 2.335
macrocell9 | U(1,1) | 1 | \SPIS:BSPIS:mosi_to_dp\ | \SPIS:BSPIS:mosi_to_dp\/main_4 | \SPIS:BSPIS:mosi_to_dp\/q | 3.350
Route | | 1 | \SPIS:BSPIS:mosi_to_dp\ | \SPIS:BSPIS:mosi_to_dp\/q | \SPIS:BSPIS:sR8:Dp:u0\/route_si | 2.924
datapathcell1 | U(1,2) | 1 | \SPIS:BSPIS:sR8:Dp:u0\ | | SETUP | 1.970
Clock | | | | | Skew | -0.927

+ Hold Subsection

+ Source Clock : CyBUS_CLK : Positive edge

+ Destination Clock : UART_1_IntClock : Positive edge

Source | Destination | Slack (ns) | Violation
Rx_1(0)/fb | \UART_1:BUART:rx_state_0\/main_9 | 7.132

Type | Location | Fanout | Instance/Net | Source | Dest | Delay (ns)
iocell6 | P12[6] | 1 | Rx_1(0) | Rx_1(0)/in_clock | Rx_1(0)/fb | 2.009
Route | | 1 | Net_39 | Rx_1(0)/fb | \UART_1:BUART:rx_state_0\/main_9 | 5.123
macrocell27 | U(0,0) | 1 | \UART_1:BUART:rx_state_0\ | | HOLD | 0.000
Clock | | | | | Skew | 0.000
Rx_1(0)/fb | \UART_1:BUART:rx_last\/main_0 | 7.132

Type | Location | Fanout | Instance/Net | Source | Dest | Delay (ns)
iocell6 | P12[6] | 1 | Rx_1(0) | Rx_1(0)/in_clock | Rx_1(0)/fb | 2.009
Route | | 1 | Net_39 | Rx_1(0)/fb | \UART_1:BUART:rx_last\/main_0 | 5.123
macrocell36 | U(0,0) | 1 | \UART_1:BUART:rx_last\ | | HOLD | 0.000
Clock | | | | | Skew | 0.000
Rx_1(0)/fb | \UART_1:BUART:rx_state_2\/main_8 | 7.143

Type | Location | Fanout | Instance/Net | Source | Dest | Delay (ns)
iocell6 | P12[6] | 1 | Rx_1(0) | Rx_1(0)/in_clock | Rx_1(0)/fb | 2.009
Route | | 1 | Net_39 | Rx_1(0)/fb | \UART_1:BUART:rx_state_2\/main_8 | 5.134
macrocell30 | U(0,0) | 1 | \UART_1:BUART:rx_state_2\ | | HOLD | 0.000
Clock | | | | | Skew | 0.000
Rx_1(0)/fb | \UART_1:BUART:rx_status_3\/main_6 | 7.143

Type | Location | Fanout | Instance/Net | Source | Dest | Delay (ns)
iocell6 | P12[6] | 1 | Rx_1(0) | Rx_1(0)/in_clock | Rx_1(0)/fb | 2.009
Route | | 1 | Net_39 | Rx_1(0)/fb | \UART_1:BUART:rx_status_3\/main_6 | 5.134
macrocell35 | U(0,0) | 1 | \UART_1:BUART:rx_status_3\ | | HOLD | 0.000
Clock | | | | | Skew | 0.000
Rx_1(0)/fb | \UART_1:BUART:pollcount_0\/main_2 | 8.942

Type | Location | Fanout | Instance/Net | Source | Dest | Delay (ns)
iocell6 | P12[6] | 1 | Rx_1(0) | Rx_1(0)/in_clock | Rx_1(0)/fb | 2.009
Route | | 1 | Net_39 | Rx_1(0)/fb | \UART_1:BUART:pollcount_0\/main_2 | 6.933
macrocell34 | U(0,1) | 1 | \UART_1:BUART:pollcount_0\ | | HOLD | 0.000
Clock | | | | | Skew | 0.000
Rx_1(0)/fb | \UART_1:BUART:pollcount_1\/main_3 | 9.494

Type | Location | Fanout | Instance/Net | Source | Dest | Delay (ns)
iocell6 | P12[6] | 1 | Rx_1(0) | Rx_1(0)/in_clock | Rx_1(0)/fb | 2.009
Route | | 1 | Net_39 | Rx_1(0)/fb | \UART_1:BUART:pollcount_1\/main_3 | 7.485
macrocell33 | U(0,1) | 1 | \UART_1:BUART:pollcount_1\ | | HOLD | 0.000
Clock | | | | | Skew | 0.000
Rx_1(0)/fb | \UART_1:BUART:sRX:RxShifter:u0\/route_si | 12.731

Type | Location | Fanout | Instance/Net | Source | Dest | Delay (ns)
iocell6 | P12[6] | 1 | Rx_1(0) | Rx_1(0)/in_clock | Rx_1(0)/fb | 2.009
Route | | 1 | Net_39 | Rx_1(0)/fb | \UART_1:BUART:rx_postpoll\/main_1 | 5.123
macrocell15 | U(0,0) | 1 | \UART_1:BUART:rx_postpoll\ | \UART_1:BUART:rx_postpoll\/main_1 | \UART_1:BUART:rx_postpoll\/q | 3.350
Route | | 1 | \UART_1:BUART:rx_postpoll\ | \UART_1:BUART:rx_postpoll\/q | \UART_1:BUART:sRX:RxShifter:u0\/route_si | 2.249
datapathcell4 | U(0,0) | 1 | \UART_1:BUART:sRX:RxShifter:u0\ | | HOLD | 0.000
Clock | | | | | Skew | 0.000

+ Source Clock : SPIS_IntClock : Positive edge

+ Destination Clock : SPIS_IntClock : Positive edge

Source | Destination | Slack (ns) | Violation
\SPIS:BSPIS:sync_3\/out | \SPIS:BSPIS:mosi_buf_overrun_fin\/main_0 | 4.266

Type | Location | Fanout | Instance/Net | Source | Dest | Delay (ns)
synccell | U(1,3) | 1 | \SPIS:BSPIS:sync_3\ | \SPIS:BSPIS:sync_3\/clock | \SPIS:BSPIS:sync_3\/out | 0.350
Route | | 1 | \SPIS:BSPIS:mosi_buf_overrun_reg\ | \SPIS:BSPIS:sync_3\/out | \SPIS:BSPIS:mosi_buf_overrun_fin\/main_0 | 3.916
macrocell19 | U(1,2) | 1 | \SPIS:BSPIS:mosi_buf_overrun_fin\ | | HOLD | 0.000
Clock | | | | | Skew | 0.000
\SPIS:BSPIS:sync_1\/out | \SPIS:BSPIS:dpcounter_one_reg\/main_0 | 5.045

Type | Location | Fanout | Instance/Net | Source | Dest | Delay (ns)
synccell | U(1,3) | 1 | \SPIS:BSPIS:sync_1\ | \SPIS:BSPIS:sync_1\/clock | \SPIS:BSPIS:sync_1\/out | 0.350
Route | | 1 | \SPIS:BSPIS:dpcounter_one_fin\ | \SPIS:BSPIS:sync_1\/out | \SPIS:BSPIS:dpcounter_one_reg\/main_0 | 4.695
macrocell18 | U(1,0) | 1 | \SPIS:BSPIS:dpcounter_one_reg\ | | HOLD | 0.000
Clock | | | | | Skew | 0.000
\SPIS:BSPIS:mosi_buf_overrun_fin\/q | \SPIS:BSPIS:RxStsReg\/status_5 | 7.821

Type | Location | Fanout | Instance/Net | Source | Dest | Delay (ns)
macrocell19 | U(1,2) | 1 | \SPIS:BSPIS:mosi_buf_overrun_fin\ | \SPIS:BSPIS:mosi_buf_overrun_fin\/clock_0 | \SPIS:BSPIS:mosi_buf_overrun_fin\/q | 1.250
Route | | 1 | \SPIS:BSPIS:mosi_buf_overrun_fin\ | \SPIS:BSPIS:mosi_buf_overrun_fin\/q | \SPIS:BSPIS:rx_buf_overrun\/main_1 | 2.900
macrocell4 | U(1,3) | 1 | \SPIS:BSPIS:rx_buf_overrun\ | \SPIS:BSPIS:rx_buf_overrun\/main_1 | \SPIS:BSPIS:rx_buf_overrun\/q | 3.350
Route | | 1 | \SPIS:BSPIS:rx_buf_overrun\ | \SPIS:BSPIS:rx_buf_overrun\/q | \SPIS:BSPIS:RxStsReg\/status_5 | 2.321
statusicell2 | U(0,3) | 1 | \SPIS:BSPIS:RxStsReg\ | | HOLD | -2.000
Clock | | | | | Skew | 0.000
\SPIS:BSPIS:sync_3\/out | \SPIS:BSPIS:RxStsReg\/status_5 | 8.556

Type | Location | Fanout | Instance/Net | Source | Dest | Delay (ns)
synccell | U(1,3) | 1 | \SPIS:BSPIS:sync_3\ | \SPIS:BSPIS:sync_3\/clock | \SPIS:BSPIS:sync_3\/out | 0.350
Route | | 1 | \SPIS:BSPIS:mosi_buf_overrun_reg\ | \SPIS:BSPIS:sync_3\/out | \SPIS:BSPIS:rx_buf_overrun\/main_0 | 4.535
macrocell4 | U(1,3) | 1 | \SPIS:BSPIS:rx_buf_overrun\ | \SPIS:BSPIS:rx_buf_overrun\/main_0 | \SPIS:BSPIS:rx_buf_overrun\/q | 3.350
Route | | 1 | \SPIS:BSPIS:rx_buf_overrun\ | \SPIS:BSPIS:rx_buf_overrun\/q | \SPIS:BSPIS:RxStsReg\/status_5 | 2.321
statusicell2 | U(0,3) | 1 | \SPIS:BSPIS:RxStsReg\ | | HOLD | -2.000
Clock | | | | | Skew | 0.000
\SPIS:BSPIS:sync_1\/out | \SPIS:BSPIS:TxStsReg\/status_6 | 9.237

Type | Location | Fanout | Instance/Net | Source | Dest | Delay (ns)
synccell | U(1,3) | 1 | \SPIS:BSPIS:sync_1\ | \SPIS:BSPIS:sync_1\/clock | \SPIS:BSPIS:sync_1\/out | 0.350
Route | | 1 | \SPIS:BSPIS:dpcounter_one_fin\ | \SPIS:BSPIS:sync_1\/out | \SPIS:BSPIS:byte_complete\/main_0 | 2.307
macrocell3 | U(1,3) | 1 | \SPIS:BSPIS:byte_complete\ | \SPIS:BSPIS:byte_complete\/main_0 | \SPIS:BSPIS:byte_complete\/q | 3.350
Route | | 1 | \SPIS:BSPIS:byte_complete\ | \SPIS:BSPIS:byte_complete\/q | \SPIS:BSPIS:TxStsReg\/status_6 | 5.230
statusicell1 | U(1,1) | 1 | \SPIS:BSPIS:TxStsReg\ | | HOLD | -2.000
Clock | | | | | Skew | 0.000
\SPIS:BSPIS:sync_1\/out | \SPIS:BSPIS:TxStsReg\/status_0 | 9.255

Type | Location | Fanout | Instance/Net | Source | Dest | Delay (ns)
synccell | U(1,3) | 1 | \SPIS:BSPIS:sync_1\ | \SPIS:BSPIS:sync_1\/clock | \SPIS:BSPIS:sync_1\/out | 0.350
Route | | 1 | \SPIS:BSPIS:dpcounter_one_fin\ | \SPIS:BSPIS:sync_1\/out | \SPIS:BSPIS:tx_status_0\/main_0 | 2.307
macrocell7 | U(1,3) | 1 | \SPIS:BSPIS:tx_status_0\ | \SPIS:BSPIS:tx_status_0\/main_0 | \SPIS:BSPIS:tx_status_0\/q | 3.350
Route | | 1 | \SPIS:BSPIS:tx_status_0\ | \SPIS:BSPIS:tx_status_0\/q | \SPIS:BSPIS:TxStsReg\/status_0 | 5.248
statusicell1 | U(1,1) | 1 | \SPIS:BSPIS:TxStsReg\ | | HOLD | -2.000
Clock | | | | | Skew | 0.000
\SPIS:BSPIS:dpcounter_one_reg\/q | \SPIS:BSPIS:TxStsReg\/status_6 | 12.166

Type | Location | Fanout | Instance/Net | Source | Dest | Delay (ns)
macrocell18 | U(1,0) | 1 | \SPIS:BSPIS:dpcounter_one_reg\ | \SPIS:BSPIS:dpcounter_one_reg\/clock_0 | \SPIS:BSPIS:dpcounter_one_reg\/q | 1.250
Route | | 1 | \SPIS:BSPIS:dpcounter_one_reg\ | \SPIS:BSPIS:dpcounter_one_reg\/q | \SPIS:BSPIS:byte_complete\/main_1 | 4.336
macrocell3 | U(1,3) | 1 | \SPIS:BSPIS:byte_complete\ | \SPIS:BSPIS:byte_complete\/main_1 | \SPIS:BSPIS:byte_complete\/q | 3.350
Route | | 1 | \SPIS:BSPIS:byte_complete\ | \SPIS:BSPIS:byte_complete\/q | \SPIS:BSPIS:TxStsReg\/status_6 | 5.230
statusicell1 | U(1,1) | 1 | \SPIS:BSPIS:TxStsReg\ | | HOLD | -2.000
Clock | | | | | Skew | 0.000
\SPIS:BSPIS:dpcounter_one_reg\/q | \SPIS:BSPIS:TxStsReg\/status_0 | 12.184

Type | Location | Fanout | Instance/Net | Source | Dest | Delay (ns)
macrocell18 | U(1,0) | 1 | \SPIS:BSPIS:dpcounter_one_reg\ | \SPIS:BSPIS:dpcounter_one_reg\/clock_0 | \SPIS:BSPIS:dpcounter_one_reg\/q | 1.250
Route | | 1 | \SPIS:BSPIS:dpcounter_one_reg\ | \SPIS:BSPIS:dpcounter_one_reg\/q | \SPIS:BSPIS:tx_status_0\/main_1 | 4.336
macrocell7 | U(1,3) | 1 | \SPIS:BSPIS:tx_status_0\ | \SPIS:BSPIS:tx_status_0\/main_1 | \SPIS:BSPIS:tx_status_0\/q | 3.350
Route | | 1 | \SPIS:BSPIS:tx_status_0\ | \SPIS:BSPIS:tx_status_0\/q | \SPIS:BSPIS:TxStsReg\/status_0 | 5.248
statusicell1 | U(1,1) | 1 | \SPIS:BSPIS:TxStsReg\ | | HOLD | -2.000
Clock | | | | | Skew | 0.000
\SPIS:BSPIS:sync_2\/out | \SPIS:BSPIS:TxStsReg\/status_0 | 12.661

Type | Location | Fanout | Instance/Net | Source | Dest | Delay (ns)
synccell | U(1,0) | 1 | \SPIS:BSPIS:sync_2\ | \SPIS:BSPIS:sync_2\/clock | \SPIS:BSPIS:sync_2\/out | 0.350
Route | | 1 | \SPIS:BSPIS:miso_tx_empty_reg_fin\ | \SPIS:BSPIS:sync_2\/out | \SPIS:BSPIS:tx_status_0\/main_2 | 5.713
macrocell7 | U(1,3) | 1 | \SPIS:BSPIS:tx_status_0\ | \SPIS:BSPIS:tx_status_0\/main_2 | \SPIS:BSPIS:tx_status_0\/q | 3.350
Route | | 1 | \SPIS:BSPIS:tx_status_0\ | \SPIS:BSPIS:tx_status_0\/q | \SPIS:BSPIS:TxStsReg\/status_0 | 5.248
statusicell1 | U(1,1) | 1 | \SPIS:BSPIS:TxStsReg\ | | HOLD | -2.000
Clock | | | | | Skew | 0.000

+ Source Clock : UART_1_IntClock : Positive edge

+ Destination Clock : UART_1_IntClock : Positive edge

Source | Destination | Slack (ns) | Violation
\UART_1:BUART:sTX:sCLOCK:TxBitClkGen\/ce1_reg | \UART_1:BUART:txn\/main_5 | 2.508

Type | Location | Fanout | Instance/Net | Source | Dest | Delay (ns)
datapathcell3 | U(0,2) | 1 | \UART_1:BUART:sTX:sCLOCK:TxBitClkGen\ | \UART_1:BUART:sTX:sCLOCK:TxBitClkGen\/clock | \UART_1:BUART:sTX:sCLOCK:TxBitClkGen\/ce1_reg | 0.190
Route | | 1 | \UART_1:BUART:tx_counter_dp\ | \UART_1:BUART:sTX:sCLOCK:TxBitClkGen\/ce1_reg | \UART_1:BUART:txn\/main_5 | 2.318
macrocell21 | U(0,2) | 1 | \UART_1:BUART:txn\ | | HOLD | 0.000
Clock | | | | | Skew | 0.000
\UART_1:BUART:sTX:sCLOCK:TxBitClkGen\/ce1_reg | \UART_1:BUART:tx_state_1\/main_4 | 2.508

Type | Location | Fanout | Instance/Net | Source | Dest | Delay (ns)
datapathcell3 | U(0,2) | 1 | \UART_1:BUART:sTX:sCLOCK:TxBitClkGen\ | \UART_1:BUART:sTX:sCLOCK:TxBitClkGen\/clock | \UART_1:BUART:sTX:sCLOCK:TxBitClkGen\/ce1_reg | 0.190
Route | | 1 | \UART_1:BUART:tx_counter_dp\ | \UART_1:BUART:sTX:sCLOCK:TxBitClkGen\/ce1_reg | \UART_1:BUART:tx_state_1\/main_4 | 2.318
macrocell22 | U(0,2) | 1 | \UART_1:BUART:tx_state_1\ | | HOLD | 0.000
Clock | | | | | Skew | 0.000
\UART_1:BUART:sTX:sCLOCK:TxBitClkGen\/ce0_reg | \UART_1:BUART:tx_state_0\/main_2 | 2.782

Type | Location | Fanout | Instance/Net | Source | Dest | Delay (ns)
datapathcell3 | U(0,2) | 1 | \UART_1:BUART:sTX:sCLOCK:TxBitClkGen\ | \UART_1:BUART:sTX:sCLOCK:TxBitClkGen\/clock | \UART_1:BUART:sTX:sCLOCK:TxBitClkGen\/ce0_reg | 0.190
Route | | 1 | \UART_1:BUART:tx_bitclk_enable_pre\ | \UART_1:BUART:sTX:sCLOCK:TxBitClkGen\/ce0_reg | \UART_1:BUART:tx_state_0\/main_2 | 2.592
macrocell23 | U(0,2) | 1 | \UART_1:BUART:tx_state_0\ | | HOLD | 0.000
Clock | | | | | Skew | 0.000
\UART_1:BUART:sTX:sCLOCK:TxBitClkGen\/ce0_reg | \UART_1:BUART:tx_bitclk\/main_2 | 2.782

Type | Location | Fanout | Instance/Net | Source | Dest | Delay (ns)
datapathcell3 | U(0,2) | 1 | \UART_1:BUART:sTX:sCLOCK:TxBitClkGen\ | \UART_1:BUART:sTX:sCLOCK:TxBitClkGen\/clock | \UART_1:BUART:sTX:sCLOCK:TxBitClkGen\/ce0_reg | 0.190
Route | | 1 | \UART_1:BUART:tx_bitclk_enable_pre\ | \UART_1:BUART:sTX:sCLOCK:TxBitClkGen\/ce0_reg | \UART_1:BUART:tx_bitclk\/main_2 | 2.592
macrocell25 | U(0,2) | 1 | \UART_1:BUART:tx_bitclk\ | | HOLD | 0.000
Clock | | | | | Skew | 0.000
\UART_1:BUART:sTX:sCLOCK:TxBitClkGen\/ce0_reg | \UART_1:BUART:tx_state_1\/main_2 | 2.791

Type | Location | Fanout | Instance/Net | Source | Dest | Delay (ns)
datapathcell3 | U(0,2) | 1 | \UART_1:BUART:sTX:sCLOCK:TxBitClkGen\ | \UART_1:BUART:sTX:sCLOCK:TxBitClkGen\/clock | \UART_1:BUART:sTX:sCLOCK:TxBitClkGen\/ce0_reg | 0.190
Route | | 1 | \UART_1:BUART:tx_bitclk_enable_pre\ | \UART_1:BUART:sTX:sCLOCK:TxBitClkGen\/ce0_reg | \UART_1:BUART:tx_state_1\/main_2 | 2.601
macrocell22 | U(0,2) | 1 | \UART_1:BUART:tx_state_1\ | | HOLD | 0.000
Clock | | | | | Skew | 0.000
\UART_1:BUART:sRX:RxBitCounter\/count_5 | \UART_1:BUART:rx_load_fifo\/main_6 | 3.308

Type | Location | Fanout | Instance/Net | Source | Dest | Delay (ns)
count7cell | U(0,0) | 1 | \UART_1:BUART:sRX:RxBitCounter\ | \UART_1:BUART:sRX:RxBitCounter\/clock | \UART_1:BUART:sRX:RxBitCounter\/count_5 | 0.620
Route | | 1 | \UART_1:BUART:rx_count_5\ | \UART_1:BUART:sRX:RxBitCounter\/count_5 | \UART_1:BUART:rx_load_fifo\/main_6 | 2.688
macrocell28 | U(0,0) | 1 | \UART_1:BUART:rx_load_fifo\ | | HOLD | 0.000
Clock | | | | | Skew | 0.000
\UART_1:BUART:sRX:RxBitCounter\/count_5 | \UART_1:BUART:rx_state_2\/main_6 | 3.308

Type | Location | Fanout | Instance/Net | Source | Dest | Delay (ns)
count7cell | U(0,0) | 1 | \UART_1:BUART:sRX:RxBitCounter\ | \UART_1:BUART:sRX:RxBitCounter\/clock | \UART_1:BUART:sRX:RxBitCounter\/count_5 | 0.620
Route | | 1 | \UART_1:BUART:rx_count_5\ | \UART_1:BUART:sRX:RxBitCounter\/count_5 | \UART_1:BUART:rx_state_2\/main_6 | 2.688
macrocell30 | U(0,0) | 1 | \UART_1:BUART:rx_state_2\ | | HOLD | 0.000
Clock | | | | | Skew | 0.000
\UART_1:BUART:sRX:RxBitCounter\/count_5 | \UART_1:BUART:rx_state_0\/main_6 | 3.341

Type | Location | Fanout | Instance/Net | Source | Dest | Delay (ns)
count7cell | U(0,0) | 1 | \UART_1:BUART:sRX:RxBitCounter\ | \UART_1:BUART:sRX:RxBitCounter\/clock | \UART_1:BUART:sRX:RxBitCounter\/count_5 | 0.620
Route | | 1 | \UART_1:BUART:rx_count_5\ | \UART_1:BUART:sRX:RxBitCounter\/count_5 | \UART_1:BUART:rx_state_0\/main_6 | 2.721
macrocell27 | U(0,0) | 1 | \UART_1:BUART:rx_state_0\ | | HOLD | 0.000
Clock | | | | | Skew | 0.000
\UART_1:BUART:sTX:sCLOCK:TxBitClkGen\/ce1_reg | \UART_1:BUART:tx_state_2\/main_4 | 3.433

Type | Location | Fanout | Instance/Net | Source | Dest | Delay (ns)
datapathcell3 | U(0,2) | 1 | \UART_1:BUART:sTX:sCLOCK:TxBitClkGen\ | \UART_1:BUART:sTX:sCLOCK:TxBitClkGen\/clock | \UART_1:BUART:sTX:sCLOCK:TxBitClkGen\/ce1_reg | 0.190
Route | | 1 | \UART_1:BUART:tx_counter_dp\ | \UART_1:BUART:sTX:sCLOCK:TxBitClkGen\/ce1_reg | \UART_1:BUART:tx_state_2\/main_4 | 3.243
macrocell24 | U(0,1) | 1 | \UART_1:BUART:tx_state_2\ | | HOLD | 0.000
Clock | | | | | Skew | 0.000
\UART_1:BUART:sRX:RxBitCounter\/count_0 | \UART_1:BUART:rx_bitclk_enable\/main_2 | 3.468

Type | Location | Fanout | Instance/Net | Source | Dest | Delay (ns)
count7cell | U(0,0) | 1 | \UART_1:BUART:sRX:RxBitCounter\ | \UART_1:BUART:sRX:RxBitCounter\/clock | \UART_1:BUART:sRX:RxBitCounter\/count_0 | 0.620
Route | | 1 | \UART_1:BUART:rx_count_0\ | \UART_1:BUART:sRX:RxBitCounter\/count_0 | \UART_1:BUART:rx_bitclk_enable\/main_2 | 2.848
macrocell31 | U(0,1) | 1 | \UART_1:BUART:rx_bitclk_enable\ | | HOLD | 0.000
Clock | | | | | Skew | 0.000

+ Source Clock : sclk(0)_PAD : Positive edge

+ Destination Clock : sclk(0)_PAD : Negative edge

Source | Destination | Slack (ns) | Violation
\SPIS:BSPIS:mosi_tmp\/q | \SPIS:BSPIS:sR8:Dp:u0\/route_si | 5007.311

Type | Location | Fanout | Instance/Net | Source | Dest | Delay (ns)
macrocell20 | U(1,1) | 1 | \SPIS:BSPIS:mosi_tmp\ | \SPIS:BSPIS:mosi_tmp\/clock_0 | \SPIS:BSPIS:mosi_tmp\/q | 1.250
Route | | 1 | \SPIS:BSPIS:mosi_tmp\ | \SPIS:BSPIS:mosi_tmp\/q | \SPIS:BSPIS:mosi_to_dp\/main_5 | 2.285
macrocell9 | U(1,1) | 1 | \SPIS:BSPIS:mosi_to_dp\ | \SPIS:BSPIS:mosi_to_dp\/main_5 | \SPIS:BSPIS:mosi_to_dp\/q | 3.350
Route | | 1 | \SPIS:BSPIS:mosi_to_dp\ | \SPIS:BSPIS:mosi_to_dp\/q | \SPIS:BSPIS:sR8:Dp:u0\/route_si | 2.924
datapathcell1 | U(1,2) | 1 | \SPIS:BSPIS:sR8:Dp:u0\ | | HOLD | -1.570
Clock | | | | | Skew | -0.928

+ Source Clock : sclk(0)_PAD : Negative edge

+ Destination Clock : sclk(0)_PAD : Positive edge

Source | Destination | Slack (ns) | Violation
\SPIS:BSPIS:BitCounter\/count_0 | \SPIS:BSPIS:sR8:Dp:u0\/f1_load | 5005.167

Type | Location | Fanout | Instance/Net | Source | Dest | Delay (ns)
count7cell | U(0,1) | 1 | \SPIS:BSPIS:BitCounter\ | \SPIS:BSPIS:BitCounter\/clock_n | \SPIS:BSPIS:BitCounter\/count_0 | 0.620
Route | | 1 | \SPIS:BSPIS:count_0\ | \SPIS:BSPIS:BitCounter\/count_0 | \SPIS:BSPIS:tx_load\/main_3 | 3.194
macrocell2 | U(1,2) | 1 | \SPIS:BSPIS:tx_load\ | \SPIS:BSPIS:tx_load\/main_3 | \SPIS:BSPIS:tx_load\/q | 3.350
Route | | 1 | \SPIS:BSPIS:tx_load\ | \SPIS:BSPIS:tx_load\/q | \SPIS:BSPIS:sR8:Dp:u0\/f1_load | 2.320
datapathcell1 | U(1,2) | 1 | \SPIS:BSPIS:sR8:Dp:u0\ | | HOLD | -3.390
Clock | | | | | Skew | -0.927
\SPIS:BSPIS:BitCounter\/count_3 | \SPIS:BSPIS:sR8:Dp:u0\/f1_load | 5005.168

Type | Location | Fanout | Instance/Net | Source | Dest | Delay (ns)
count7cell | U(0,1) | 1 | \SPIS:BSPIS:BitCounter\ | \SPIS:BSPIS:BitCounter\/clock_n | \SPIS:BSPIS:BitCounter\/count_3 | 0.620
Route | | 1 | \SPIS:BSPIS:count_3\ | \SPIS:BSPIS:BitCounter\/count_3 | \SPIS:BSPIS:tx_load\/main_0 | 3.195
macrocell2 | U(1,2) | 1 | \SPIS:BSPIS:tx_load\ | \SPIS:BSPIS:tx_load\/main_0 | \SPIS:BSPIS:tx_load\/q | 3.350
Route | | 1 | \SPIS:BSPIS:tx_load\ | \SPIS:BSPIS:tx_load\/q | \SPIS:BSPIS:sR8:Dp:u0\/f1_load | 2.320
datapathcell1 | U(1,2) | 1 | \SPIS:BSPIS:sR8:Dp:u0\ | | HOLD | -3.390
Clock | | | | | Skew | -0.927
\SPIS:BSPIS:BitCounter\/count_2 | \SPIS:BSPIS:sR8:Dp:u0\/f1_load | 5005.353

Type | Location | Fanout | Instance/Net | Source | Dest | Delay (ns)
count7cell | U(0,1) | 1 | \SPIS:BSPIS:BitCounter\ | \SPIS:BSPIS:BitCounter\/clock_n | \SPIS:BSPIS:BitCounter\/count_2 | 0.620
Route | | 1 | \SPIS:BSPIS:count_2\ | \SPIS:BSPIS:BitCounter\/count_2 | \SPIS:BSPIS:tx_load\/main_1 | 3.380
macrocell2 | U(1,2) | 1 | \SPIS:BSPIS:tx_load\ | \SPIS:BSPIS:tx_load\/main_1 | \SPIS:BSPIS:tx_load\/q | 3.350
Route | | 1 | \SPIS:BSPIS:tx_load\ | \SPIS:BSPIS:tx_load\/q | \SPIS:BSPIS:sR8:Dp:u0\/f1_load | 2.320
datapathcell1 | U(1,2) | 1 | \SPIS:BSPIS:sR8:Dp:u0\ | | HOLD | -3.390
Clock | | | | | Skew | -0.927
\SPIS:BSPIS:BitCounter\/count_1 | \SPIS:BSPIS:sR8:Dp:u0\/f1_load | 5005.360

Type | Location | Fanout | Instance/Net | Source | Dest | Delay (ns)
count7cell | U(0,1) | 1 | \SPIS:BSPIS:BitCounter\ | \SPIS:BSPIS:BitCounter\/clock_n | \SPIS:BSPIS:BitCounter\/count_1 | 0.620
Route | | 1 | \SPIS:BSPIS:count_1\ | \SPIS:BSPIS:BitCounter\/count_1 | \SPIS:BSPIS:tx_load\/main_2 | 3.387
macrocell2 | U(1,2) | 1 | \SPIS:BSPIS:tx_load\ | \SPIS:BSPIS:tx_load\/main_2 | \SPIS:BSPIS:tx_load\/q | 3.350
Route | | 1 | \SPIS:BSPIS:tx_load\ | \SPIS:BSPIS:tx_load\/q | \SPIS:BSPIS:sR8:Dp:u0\/f1_load | 2.320
datapathcell1 | U(1,2) | 1 | \SPIS:BSPIS:sR8:Dp:u0\ | | HOLD | -3.390
Clock | | | | | Skew | -0.927

+ Destination Clock : sclk(0)_PAD : Negative edge

Source | Destination | Slack (ns) | Violation
\SPIS:BSPIS:BitCounter\/count_0 | \SPIS:BSPIS:sR8:Dp:u0\/route_si | 6.732

Type | Location | Fanout | Instance/Net | Source | Dest | Delay (ns)
count7cell | U(0,1) | 1 | \SPIS:BSPIS:BitCounter\ | \SPIS:BSPIS:BitCounter\/clock_n | \SPIS:BSPIS:BitCounter\/count_0 | 0.620
Route | | 1 | \SPIS:BSPIS:count_0\ | \SPIS:BSPIS:BitCounter\/count_0 | \SPIS:BSPIS:mosi_to_dp\/main_4 | 2.335
macrocell9 | U(1,1) | 1 | \SPIS:BSPIS:mosi_to_dp\ | \SPIS:BSPIS:mosi_to_dp\/main_4 | \SPIS:BSPIS:mosi_to_dp\/q | 3.350
Route | | 1 | \SPIS:BSPIS:mosi_to_dp\ | \SPIS:BSPIS:mosi_to_dp\/q | \SPIS:BSPIS:sR8:Dp:u0\/route_si | 2.924
datapathcell1 | U(1,2) | 1 | \SPIS:BSPIS:sR8:Dp:u0\ | | HOLD | -1.570
Clock | | | | | Skew | -0.927
\SPIS:BSPIS:BitCounter\/count_3 | \SPIS:BSPIS:sR8:Dp:u0\/route_si | 6.735

Type | Location | Fanout | Instance/Net | Source | Dest | Delay (ns)
count7cell | U(0,1) | 1 | \SPIS:BSPIS:BitCounter\ | \SPIS:BSPIS:BitCounter\/clock_n | \SPIS:BSPIS:BitCounter\/count_3 | 0.620
Route | | 1 | \SPIS:BSPIS:count_3\ | \SPIS:BSPIS:BitCounter\/count_3 | \SPIS:BSPIS:mosi_to_dp\/main_1 | 2.338
macrocell9 | U(1,1) | 1 | \SPIS:BSPIS:mosi_to_dp\ | \SPIS:BSPIS:mosi_to_dp\/main_1 | \SPIS:BSPIS:mosi_to_dp\/q | 3.350
Route | | 1 | \SPIS:BSPIS:mosi_to_dp\ | \SPIS:BSPIS:mosi_to_dp\/q | \SPIS:BSPIS:sR8:Dp:u0\/route_si | 2.924
datapathcell1 | U(1,2) | 1 | \SPIS:BSPIS:sR8:Dp:u0\ | | HOLD | -1.570
Clock | | | | | Skew | -0.927
\SPIS:BSPIS:BitCounter\/count_2 | \SPIS:BSPIS:sR8:Dp:u0\/route_si | 7.046

Type | Location | Fanout | Instance/Net | Source | Dest | Delay (ns)
count7cell | U(0,1) | 1 | \SPIS:BSPIS:BitCounter\ | \SPIS:BSPIS:BitCounter\/clock_n | \SPIS:BSPIS:BitCounter\/count_2 | 0.620
Route | | 1 | \SPIS:BSPIS:count_2\ | \SPIS:BSPIS:BitCounter\/count_2 | \SPIS:BSPIS:mosi_to_dp\/main_2 | 2.649
macrocell9 | U(1,1) | 1 | \SPIS:BSPIS:mosi_to_dp\ | \SPIS:BSPIS:mosi_to_dp\/main_2 | \SPIS:BSPIS:mosi_to_dp\/q | 3.350
Route | | 1 | \SPIS:BSPIS:mosi_to_dp\ | \SPIS:BSPIS:mosi_to_dp\/q | \SPIS:BSPIS:sR8:Dp:u0\/route_si | 2.924
datapathcell1 | U(1,2) | 1 | \SPIS:BSPIS:sR8:Dp:u0\ | | HOLD | -1.570
Clock | | | | | Skew | -0.927
\SPIS:BSPIS:BitCounter\/count_1 | \SPIS:BSPIS:sR8:Dp:u0\/route_si | 7.062

Type | Location | Fanout | Instance/Net | Source | Dest | Delay (ns)
count7cell | U(0,1) | 1 | \SPIS:BSPIS:BitCounter\ | \SPIS:BSPIS:BitCounter\/clock_n | \SPIS:BSPIS:BitCounter\/count_1 | 0.620
Route | | 1 | \SPIS:BSPIS:count_1\ | \SPIS:BSPIS:BitCounter\/count_1 | \SPIS:BSPIS:mosi_to_dp\/main_3 | 2.665
macrocell9 | U(1,1) | 1 | \SPIS:BSPIS:mosi_to_dp\ | \SPIS:BSPIS:mosi_to_dp\/main_3 | \SPIS:BSPIS:mosi_to_dp\/q | 3.350
Route | | 1 | \SPIS:BSPIS:mosi_to_dp\ | \SPIS:BSPIS:mosi_to_dp\/q | \SPIS:BSPIS:sR8:Dp:u0\/route_si | 2.924
datapathcell1 | U(1,2) | 1 | \SPIS:BSPIS:sR8:Dp:u0\ | | HOLD | -1.570
Clock | | | | | Skew | -0.927
\SPIS:BSPIS:BitCounter\/count_0 | \SPIS:BSPIS:sR8:Dp:u0\/cs_addr_0 | 8.557

Type | Location | Fanout | Instance/Net | Source | Dest | Delay (ns)
count7cell | U(0,1) | 1 | \SPIS:BSPIS:BitCounter\ | \SPIS:BSPIS:BitCounter\/clock_n | \SPIS:BSPIS:BitCounter\/count_0 | 0.620
Route | | 1 | \SPIS:BSPIS:count_0\ | \SPIS:BSPIS:BitCounter\/count_0 | \SPIS:BSPIS:tx_load\/main_3 | 3.194
macrocell2 | U(1,2) | 1 | \SPIS:BSPIS:tx_load\ | \SPIS:BSPIS:tx_load\/main_3 | \SPIS:BSPIS:tx_load\/q | 3.350
Route | | 1 | \SPIS:BSPIS:tx_load\ | \SPIS:BSPIS:tx_load\/q | \SPIS:BSPIS:sR8:Dp:u0\/cs_addr_0 | 2.320
datapathcell1 | U(1,2) | 1 | \SPIS:BSPIS:sR8:Dp:u0\ | | HOLD | 0.000
Clock | | | | | Skew | -0.927
\SPIS:BSPIS:BitCounter\/count_3 | \SPIS:BSPIS:sR8:Dp:u0\/cs_addr_0 | 8.558

Type | Location | Fanout | Instance/Net | Source | Dest | Delay (ns)
count7cell | U(0,1) | 1 | \SPIS:BSPIS:BitCounter\ | \SPIS:BSPIS:BitCounter\/clock_n | \SPIS:BSPIS:BitCounter\/count_3 | 0.620
Route | | 1 | \SPIS:BSPIS:count_3\ | \SPIS:BSPIS:BitCounter\/count_3 | \SPIS:BSPIS:tx_load\/main_0 | 3.195
macrocell2 | U(1,2) | 1 | \SPIS:BSPIS:tx_load\ | \SPIS:BSPIS:tx_load\/main_0 | \SPIS:BSPIS:tx_load\/q | 3.350
Route | | 1 | \SPIS:BSPIS:tx_load\ | \SPIS:BSPIS:tx_load\/q | \SPIS:BSPIS:sR8:Dp:u0\/cs_addr_0 | 2.320
datapathcell1 | U(1,2) | 1 | \SPIS:BSPIS:sR8:Dp:u0\ | | HOLD | 0.000
Clock | | | | | Skew | -0.927
\SPIS:BSPIS:BitCounter\/count_2 | \SPIS:BSPIS:sR8:Dp:u0\/cs_addr_0 | 8.743

Type | Location | Fanout | Instance/Net | Source | Dest | Delay (ns)
count7cell | U(0,1) | 1 | \SPIS:BSPIS:BitCounter\ | \SPIS:BSPIS:BitCounter\/clock_n | \SPIS:BSPIS:BitCounter\/count_2 | 0.620
Route | | 1 | \SPIS:BSPIS:count_2\ | \SPIS:BSPIS:BitCounter\/count_2 | \SPIS:BSPIS:tx_load\/main_1 | 3.380
macrocell2 | U(1,2) | 1 | \SPIS:BSPIS:tx_load\ | \SPIS:BSPIS:tx_load\/main_1 | \SPIS:BSPIS:tx_load\/q | 3.350
Route | | 1 | \SPIS:BSPIS:tx_load\ | \SPIS:BSPIS:tx_load\/q | \SPIS:BSPIS:sR8:Dp:u0\/cs_addr_0 | 2.320
datapathcell1 | U(1,2) | 1 | \SPIS:BSPIS:sR8:Dp:u0\ | | HOLD | 0.000
Clock | | | | | Skew | -0.927
\SPIS:BSPIS:BitCounter\/count_1 | \SPIS:BSPIS:sR8:Dp:u0\/cs_addr_0 | 8.750

Type | Location | Fanout | Instance/Net | Source | Dest | Delay (ns)
count7cell | U(0,1) | 1 | \SPIS:BSPIS:BitCounter\ | \SPIS:BSPIS:BitCounter\/clock_n | \SPIS:BSPIS:BitCounter\/count_1 | 0.620
Route | | 1 | \SPIS:BSPIS:count_1\ | \SPIS:BSPIS:BitCounter\/count_1 | \SPIS:BSPIS:tx_load\/main_2 | 3.387
macrocell2 | U(1,2) | 1 | \SPIS:BSPIS:tx_load\ | \SPIS:BSPIS:tx_load\/main_2 | \SPIS:BSPIS:tx_load\/q | 3.350
Route | | 1 | \SPIS:BSPIS:tx_load\ | \SPIS:BSPIS:tx_load\/q | \SPIS:BSPIS:sR8:Dp:u0\/cs_addr_0 | 2.320
datapathcell1 | U(1,2) | 1 | \SPIS:BSPIS:sR8:Dp:u0\ | | HOLD | 0.000
Clock | | | | | Skew | -0.927

+ Input To Output Section

Source | Destination | Delay (ns)
ss(0)_PAD | miso(0)_PAD | 38.852

Type | Location | Fanout | Instance/Net | Source | Dest | Delay (ns)
Design01 | | 1 | ss(0)_PAD | ss(0)_PAD | ss(0)_PAD | 0.000
Route | | 1 | ss(0)_PAD | ss(0)_PAD | ss(0)/pad_in | 0.000
iocell5 | P1[4] | 1 | ss(0) | ss(0)/pad_in | ss(0)/fb | 7.732
Route | | 1 | Net_51 | ss(0)/fb | Net_30/main_0 | 6.058
macrocell5 | U(1,1) | 1 | Net_30 | Net_30/main_0 | Net_30/q | 3.350
Route | | 1 | Net_30 | Net_30/q | miso(0)/pin_input | 6.331
iocell2 | P1[7] | 1 | miso(0) | miso(0)/pin_input | miso(0)/pad_out | 15.381
Route | | 1 | miso(0)_PAD | miso(0)/pad_out | miso(0)_PAD | 0.000

+ Input To Clock Section

+ sclk(0)_PAD

Source | Destination | Delay (ns)
ss(0)_PAD | \SPIS:BSPIS:BitCounter\/enable | 14.148

Type | Location | Fanout | Instance/Net | Source | Dest | Delay (ns)
Route | | 1 | ss(0)_PAD | ss(0)_PAD | ss(0)/pad_in | 0.000
iocell5 | P1[4] | 1 | ss(0) | ss(0)/pad_in | ss(0)/fb | 7.732
Route | | 1 | Net_51 | ss(0)/fb | \SPIS:BSPIS:inv_ss\/main_0 | 7.579
macrocell1 | U(1,3) | 1 | \SPIS:BSPIS:inv_ss\ | \SPIS:BSPIS:inv_ss\/main_0 | \SPIS:BSPIS:inv_ss\/q | 3.350
Route | | 1 | \SPIS:BSPIS:inv_ss\ | \SPIS:BSPIS:inv_ss\/q | \SPIS:BSPIS:BitCounter\/enable | 4.343
count7cell | U(0,1) | 1 | \SPIS:BSPIS:BitCounter\ | | SETUP | 4.060
Clock | | | | | Clock path delay | -12.916
mosi(0)_PAD | \SPIS:BSPIS:sR8:Dp:u0\/route_si | 8.138

Type | Location | Fanout | Instance/Net | Source | Dest | Delay (ns)
Route | | 1 | mosi(0)_PAD | mosi(0)_PAD | mosi(0)/pad_in | 0.000
iocell1 | P1[6] | 1 | mosi(0) | mosi(0)/pad_in | mosi(0)/fb | 7.843
Route | | 1 | Net_8 | mosi(0)/fb | \SPIS:BSPIS:mosi_to_dp\/main_0 | 5.894
macrocell9 | U(1,1) | 1 | \SPIS:BSPIS:mosi_to_dp\ | \SPIS:BSPIS:mosi_to_dp\/main_0 | \SPIS:BSPIS:mosi_to_dp\/q | 3.350
Route | | 1 | \SPIS:BSPIS:mosi_to_dp\ | \SPIS:BSPIS:mosi_to_dp\/q | \SPIS:BSPIS:sR8:Dp:u0\/route_si | 2.924
datapathcell1 | U(1,2) | 1 | \SPIS:BSPIS:sR8:Dp:u0\ | | SETUP | 1.970
Clock | | | | | Clock path delay | -13.843
mosi(0)_PAD | \SPIS:BSPIS:mosi_tmp\/main_0 | 4.345

Type | Location | Fanout | Instance/Net | Source | Dest | Delay (ns)
Route | | 1 | mosi(0)_PAD | mosi(0)_PAD | mosi(0)/pad_in | 0.000
iocell1 | P1[6] | 1 | mosi(0) | mosi(0)/pad_in | mosi(0)/fb | 7.843
Route | | 1 | Net_8 | mosi(0)/fb | \SPIS:BSPIS:mosi_tmp\/main_0 | 5.907
macrocell20 | U(1,1) | 1 | \SPIS:BSPIS:mosi_tmp\ | | SETUP | 3.510
Clock | | | | | Clock path delay | -12.915

+ Clock To Output Section

+ UART_1_IntClock

Source | Destination | Delay (ns)
\UART_1:BUART:txn\/q | Tx_1(0)_PAD | 31.051

Type | Location | Fanout | Instance/Net | Source | Dest | Delay (ns)
macrocell21 | U(0,2) | 1 | \UART_1:BUART:txn\ | \UART_1:BUART:txn\/clock_0 | \UART_1:BUART:txn\/q | 1.250
Route | | 1 | \UART_1:BUART:txn\ | \UART_1:BUART:txn\/q | Net_34/main_0 | 4.107
macrocell10 | U(1,0) | 1 | Net_34 | Net_34/main_0 | Net_34/q | 3.350
Route | | 1 | Net_34 | Net_34/q | Tx_1(0)/pin_input | 5.377
iocell7 | P12[7] | 1 | Tx_1(0) | Tx_1(0)/pin_input | Tx_1(0)/pad_out | 16.967
Route | | 1 | Tx_1(0)_PAD | Tx_1(0)/pad_out | Tx_1(0)_PAD | 0.000
Clock | | | | | Clock path delay | 0.000

+ sclk(0)_PAD

Source | Destination | Delay (ns)
\SPIS:BSPIS:sR8:Dp:u0\/so_comb | miso(0)_PAD | 50.991

Type | Location | Fanout | Instance/Net | Source | Dest | Delay (ns)
datapathcell1 | U(1,2) | 1 | \SPIS:BSPIS:sR8:Dp:u0\ | \SPIS:BSPIS:sR8:Dp:u0\/clock | \SPIS:BSPIS:sR8:Dp:u0\/so_comb | 9.160
Route | | 1 | \SPIS:BSPIS:miso_from_dp\ | \SPIS:BSPIS:sR8:Dp:u0\/so_comb | Net_30/main_1 | 2.926
macrocell5 | U(1,1) | 1 | Net_30 | Net_30/main_1 | Net_30/q | 3.350
Route | | 1 | Net_30 | Net_30/q | miso(0)/pin_input | 6.331
iocell2 | P1[7] | 1 | miso(0) | miso(0)/pin_input | miso(0)/pad_out | 15.381
Route | | 1 | miso(0)_PAD | miso(0)/pad_out | miso(0)_PAD | 0.000
Clock | | | | | Clock path delay | 13.843
