MkLJensen/iFollow/RapportBilag/Design/Motor/MotorOverfoering.pdf

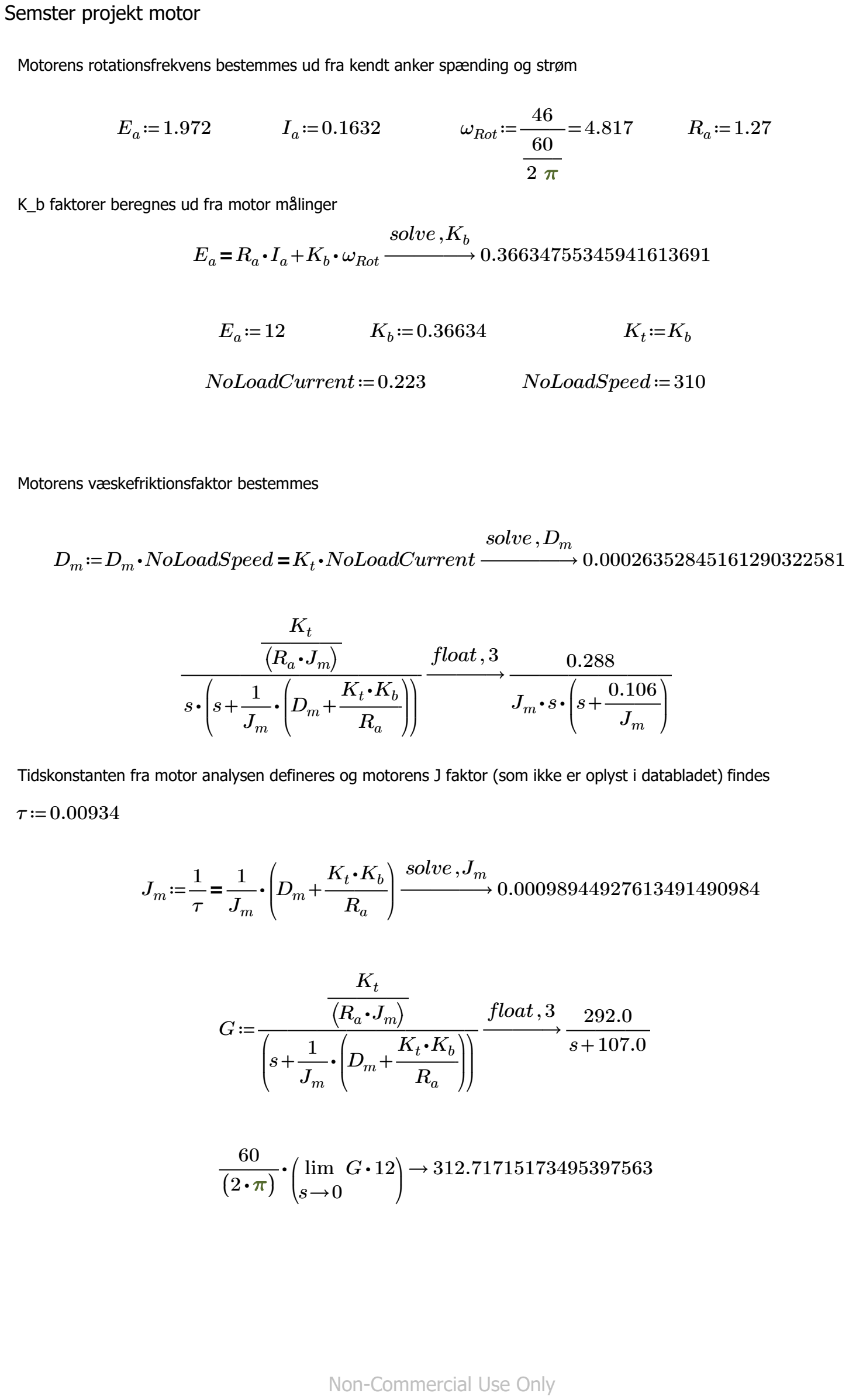
[picture p78: page 1]

Semster projekt motor | ωRot | ―――→

Motorens rotationsfrekvens bestemmes ud fra kendt anker spænding og strøm

Ea≔1.972 | Ia≔0.1632 | ωRot≔――=

46
―60―2 π

4.817 Ra≔1.27

K_b faktorer beregnes ud fra motor målinger

Ea＝Ra

⋅ Ia+Kb

⋅ωRot ―――→

solve ,Kb
0.36634755345941613691
Ea≔12 | Kb≔0.36634 | Kt≔Kb
NoLoadCurrent≔0.223 | NoLoadSpeed≔310

Motorens væskefriktionsfaktor bestemmes

Dm ≔Dm ⋅NoLoadSpeed＝Kt

⋅NoLoadCurrent ―――→

solve , Dm
0.00026352845161290322581

―――――――――――→―

―――

Kt
⎛⎝R ⋅ a Jm

⎞
⎠

s ⋅

⎛
⎜
⎝

s+――⋅

1
Jm

⎛
⎜
⎝

Dm +―――

K ⋅t Kb
Ra

⎞
⎟
⎠

⎞
⎟
⎠

float, 3 ――0.288 ――――

Jm ⋅ s ⋅

⎛
⎜
⎝

s+―0.106―Jm

⎞
⎟
⎠

Tidskonstanten fra motor analysen defineres og motorens J faktor (som ikke er oplyst i databladet) findes
τ≔0.00934
Jm ≔―＝ | ―――→

1
τ ――⋅

1
Jm

⎛
⎜
⎝
| Dm +―――

K ⋅t Kb
Ra

⎞
⎟
⎠
| solve , Jm
0.00098944927613491490984

G≔――――――――――→

―――

Kt
⎛⎝R ⋅ a Jm

⎞
⎠
⎛
⎜
⎝

s+――⋅

1
Jm

⎛
⎜
⎝

Dm +―――

K ⋅t Kb
Ra

⎞
⎟
⎠

⎞
⎟
⎠

float, 3 ―292.0 ―― s+107.0

―――⋅ | →

60
((2 ⋅π))

⎛
⎜
⎝

lim
s→0

G⋅ 12⎞
⎟
⎠

312.71715173495397563

Non-Commercial Use Only

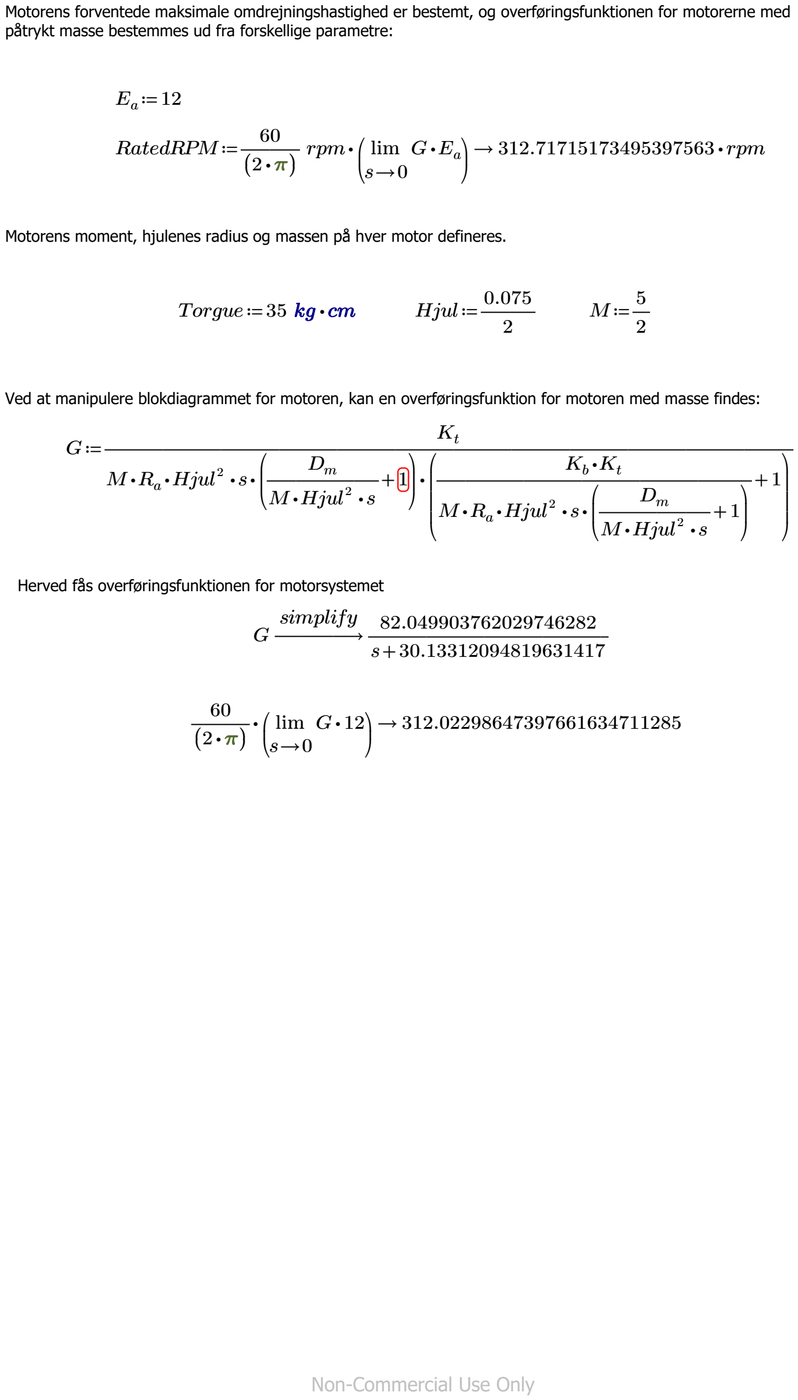
[picture p79: page 2]

Motorens forventede maksimale omdrejningshastighed er bestemt, og overføringsfunktionen for motorerne med påtrykt masse bestemmes ud fra forskellige parametre:

Ea≔12

RatedRPM≔――― ⋅ | →

60
((2 ⋅π))

rpm ⎛
⎜
⎝

lim
s→0

G⋅Ea

⎞
⎟
⎠

312.71715173495397563 ⋅ rpm

Motorens moment, hjulenes radius og massen på hver motor defineres.

Torgue≔35 kg ⋅ cm Hjul≔―0.075―2

M≔―5
2

Ved at manipulere blokdiagrammet for motoren, kan en overføringsfunktion for motoren med masse findes:

G≔――――――――――――――――――――――――

Kt

M⋅R ⋅ | ⋅ ⋅ | ⋅ a Hjul²
s

⎛
⎜
⎝

――――+

Dm
M⋅Hjul ⋅

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
―――――――――――+

K ⋅ b Kt

M⋅R ⋅ ⋅ ⋅ a Hjul²
s

⎛
⎜
⎝

――――+

Dm
M⋅Hjul ⋅

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
G ―――→

simplify ―82.049903762029746282 ―――――――― s+30.13312094819631417

Herved fås overføringsfunktionen for motorsystemet

―――⋅ | →

60
((2 ⋅π))

⎛
⎜
⎝

lim
s→0

G⋅ 12⎞
⎟
⎠

312.02298647397661634711285

Non-Commercial Use Only
