MkLJensen/iFollow/RapportBilag/Design/Motor/block_diagram_reduktion.pdf

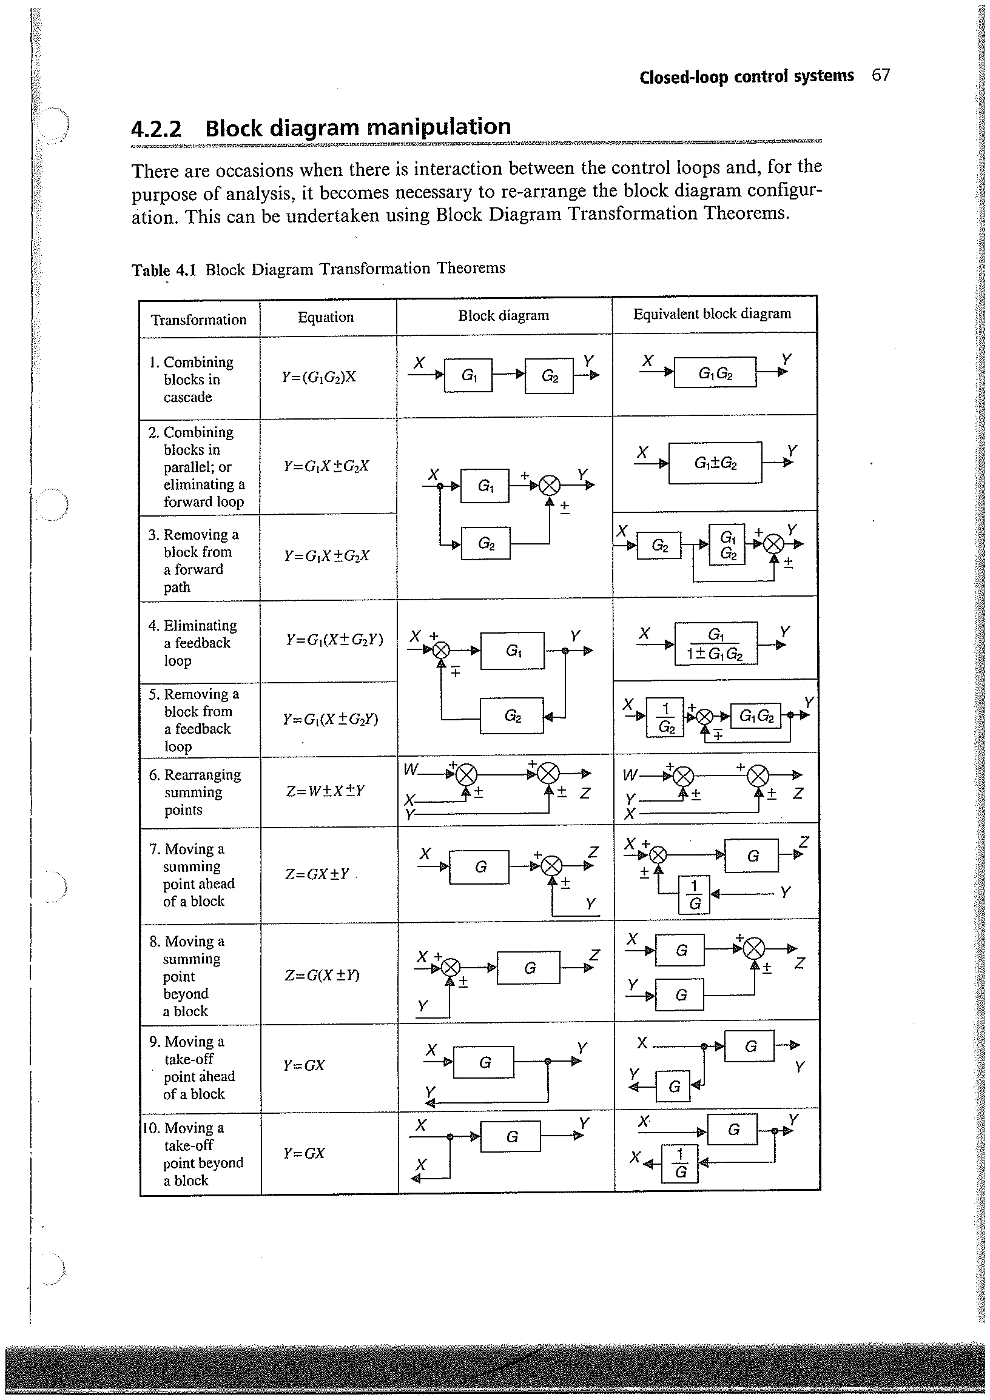
[picture p81: page 1]
