MkLJensen/iFollow/Arkitektur/Billeder/bdd_MotorCtrl.PNG

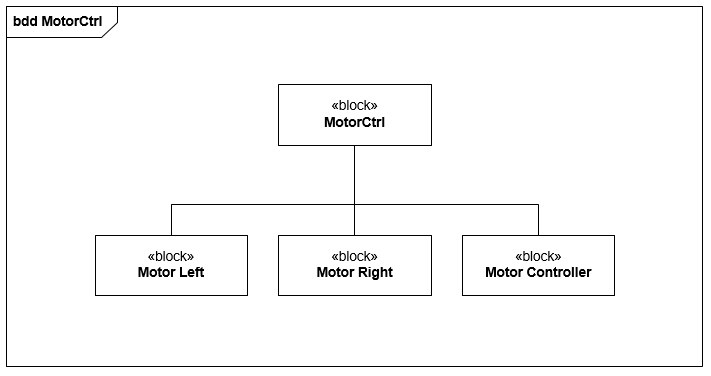
Arkitektur/Billeder/bdd_MotorCtrl.PNG
