MkLJensen/iFollow/Arkitektur/Billeder/bdd_Sensors.PNG

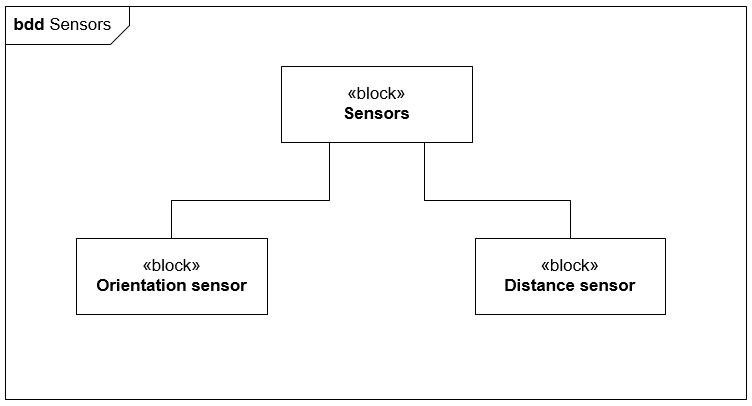
Arkitektur/Billeder/bdd_Sensors.PNG
