MkLJensen/iFollow/Arkitektur/Billeder/ibd_Power_Supply.PNG

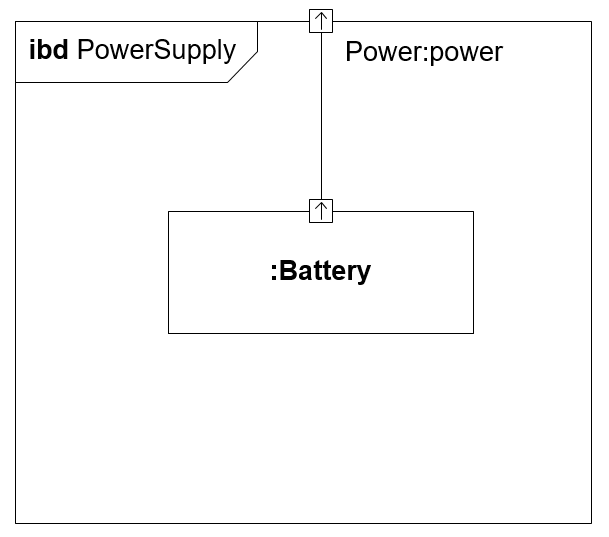
Arkitektur/Billeder/ibd_Power_Supply.PNG
