MkLJensen/iFollow/Arkitektur/Billeder/ibd_sensors.PNG

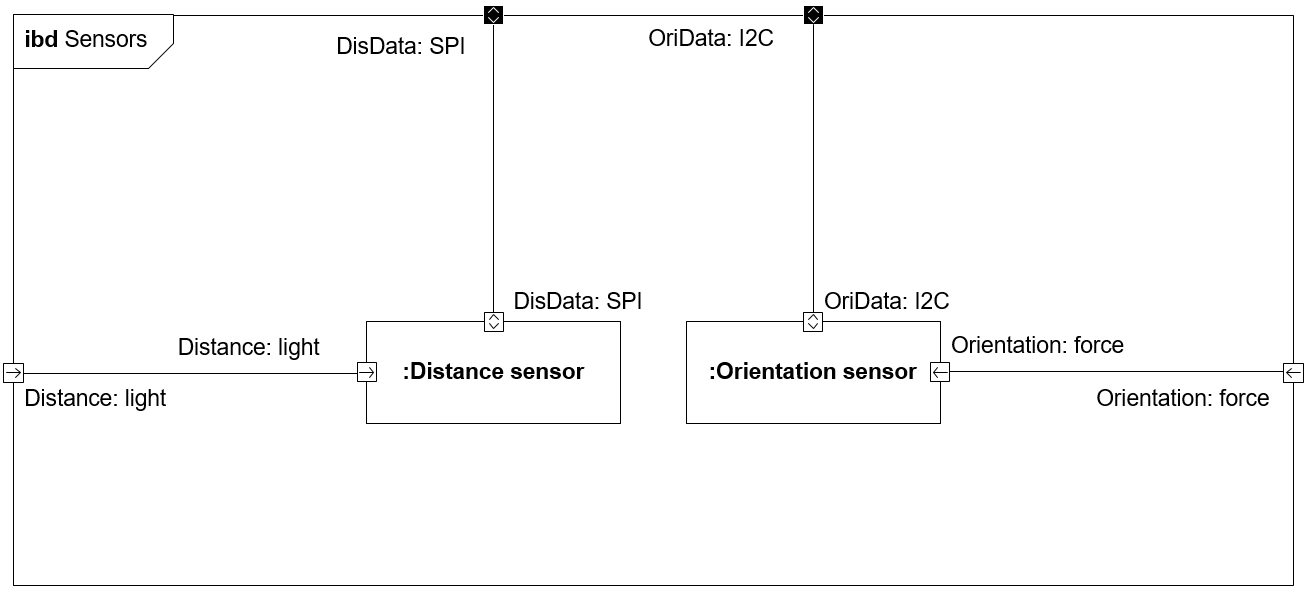
Arkitektur/Billeder/ibd_sensors.PNG
