MkLJensen/iFollow/Arkitektur/MekanikIBD.png

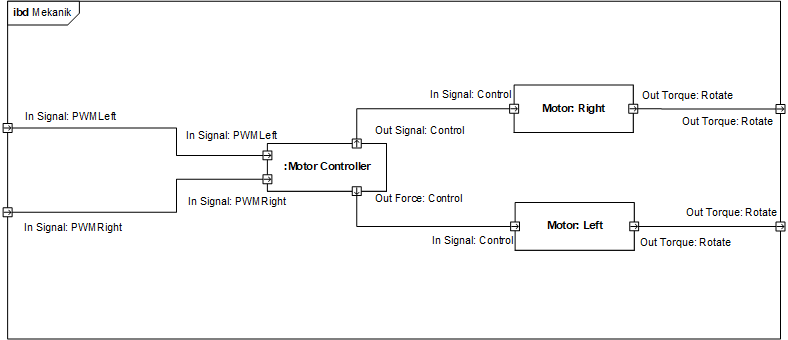
Arkitektur/MekanikIBD.png
