MkLJensen/iFollow/Arkitektur/SensorsIBD.png

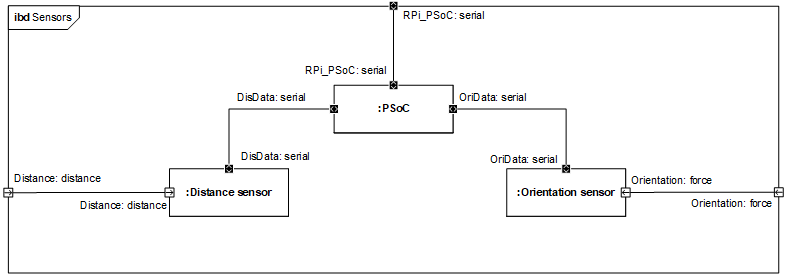
Arkitektur/SensorsIBD.png
