MkLJensen/iFollow/Arkitektur/System Sekvens Diagrammer/WebAPP_CD_UC4.png

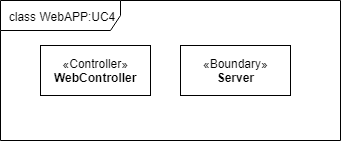
Arkitektur/System Sekvens Diagrammer/WebAPP_CD_UC4.png
