MkLJensen/iFollow/Arkitektur/System Sekvens Diagrammer/WebAPPFullClass.png

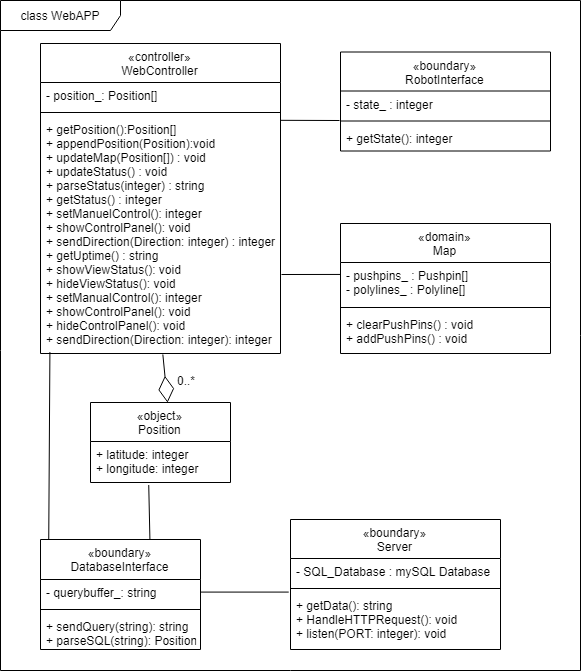
Arkitektur/System Sekvens Diagrammer/WebAPPFullClass.png
