MkLJensen/iFollow/Arkitektur/System Sekvens Diagrammer/WebAPPUC3FullClass.png

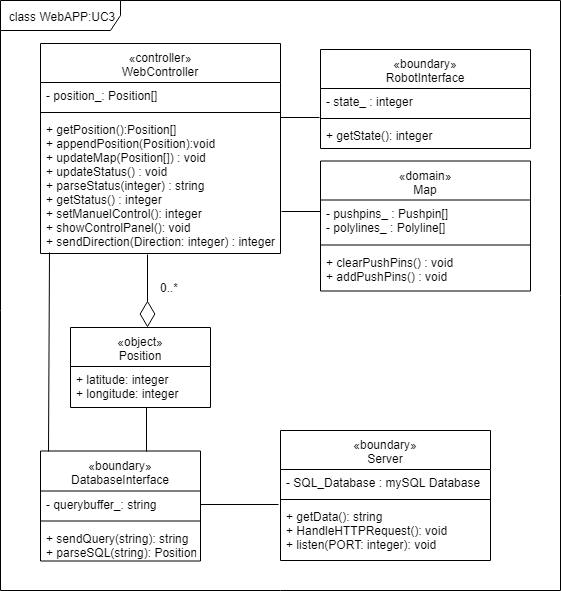
Arkitektur/System Sekvens Diagrammer/WebAPPUC3FullClass.png
