MkLJensen/iFollow/Arkitektur/System Sekvens Diagrammer/WebAPPUC4FullClass.png

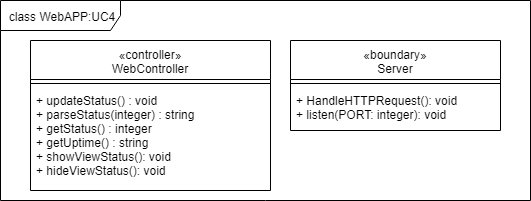
Arkitektur/System Sekvens Diagrammer/WebAPPUC4FullClass.png
