MkLJensen/iFollow/Arkitektur/SystemArkitekturBDD.png

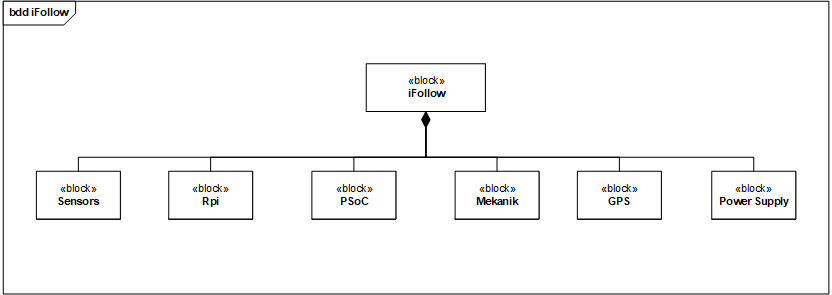
Arkitektur/SystemArkitekturBDD.png
