MkLJensen/iFollow/Krav og Design/Motor_Class.png

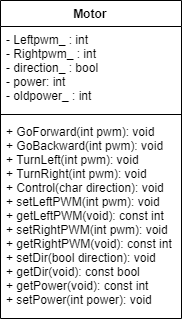
Krav og Design/Motor_Class.png
