MkLJensen/iFollow/Krav og Design/Rigt_Billede.PNG

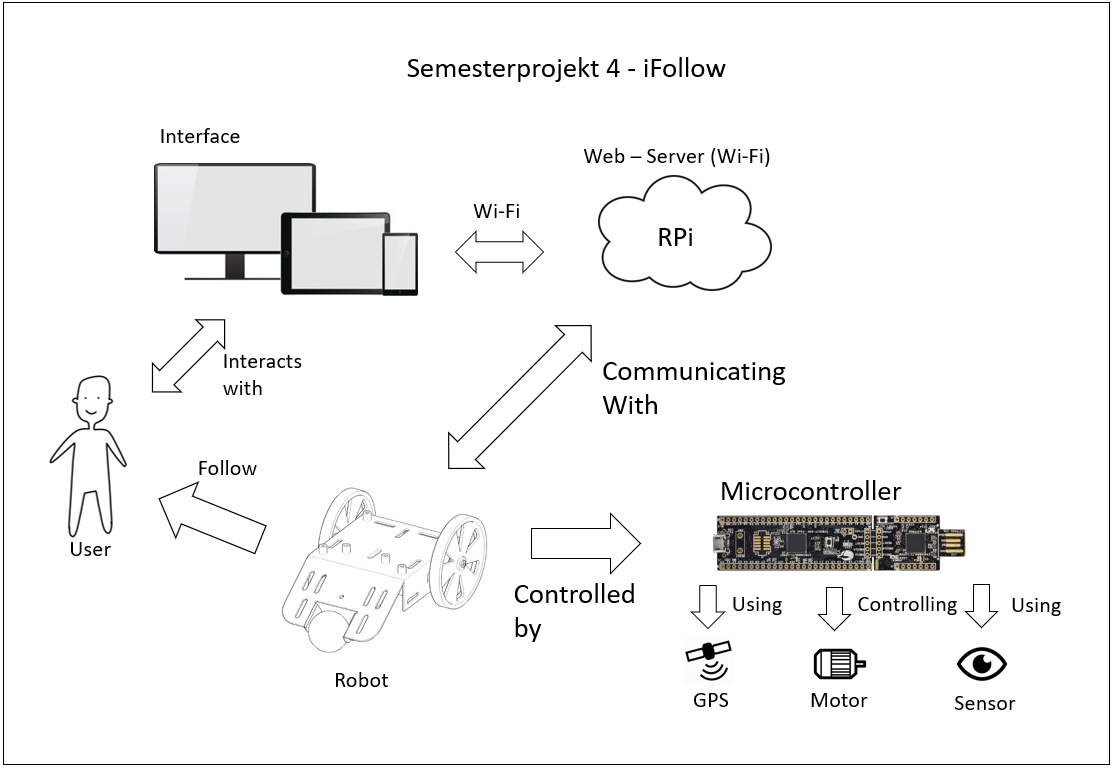
Krav og Design/Rigt_Billede.PNG
