MkLJensen/iFollow/Krav og Design/Use Cases/ac.PNG

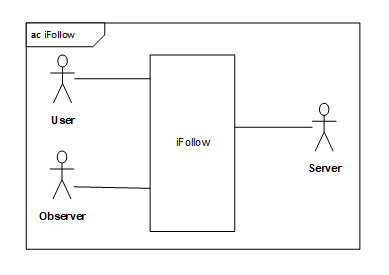
Krav og Design/Use Cases/ac.PNG
