MkLJensen/iFollow/Krav og Design/Use Cases/DomainModel.png

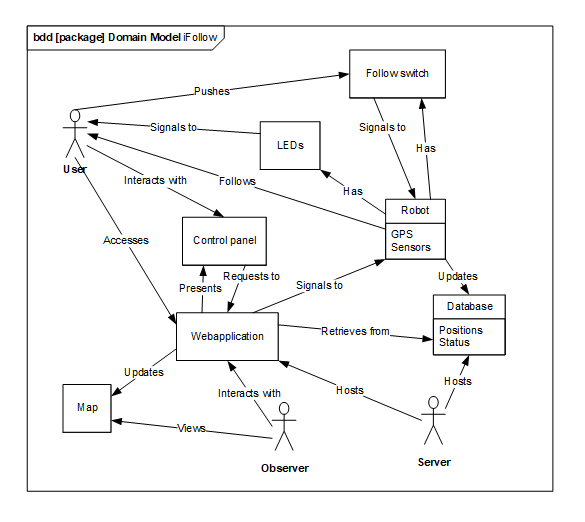
Krav og Design/Use Cases/DomainModel.png
