MkLJensen/iFollow/Krav og Design/Use Cases/uc.PNG

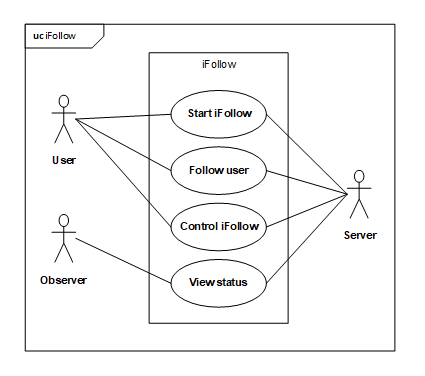
Krav og Design/Use Cases/uc.PNG
