MkLJensen/iFollow/Krav og Design/Use Cases/UC_Diagram.PNG

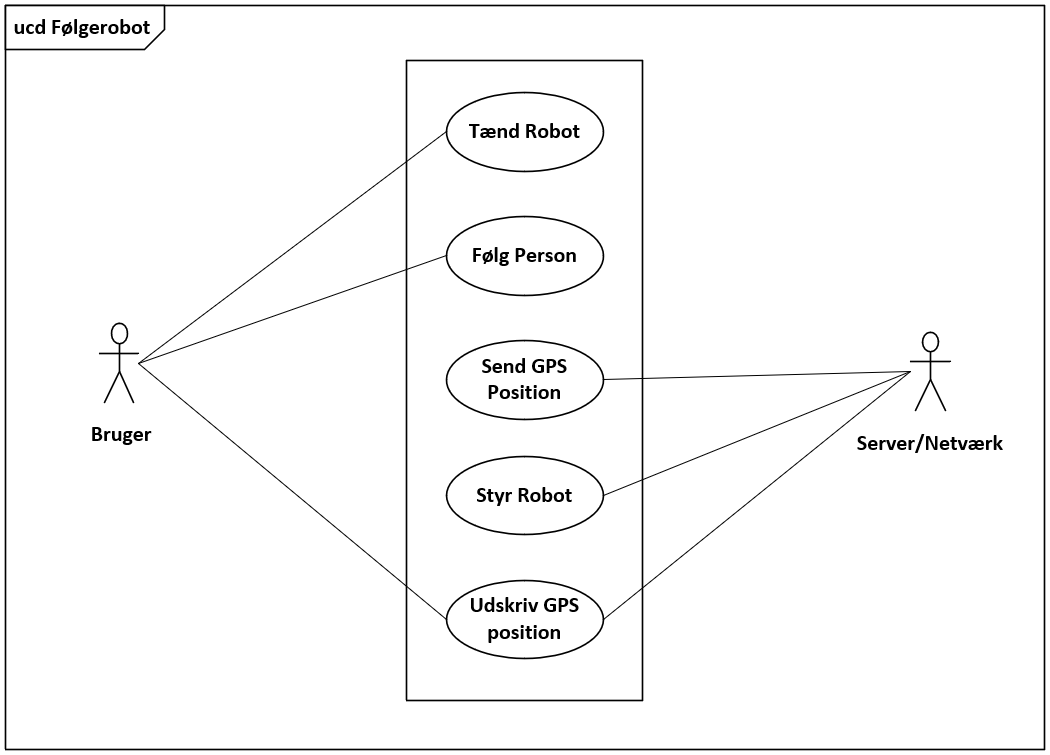
Krav og Design/Use Cases/UC_Diagram.PNG
