MkLJensen/iFollow/Krav og Design/WepAppDemo/WebAppClickRight.png

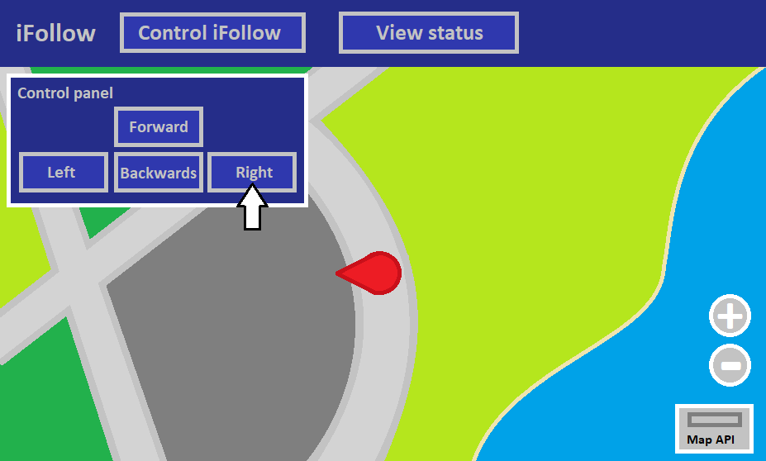
Krav og Design/WepAppDemo/WebAppClickRight.png
