MkLJensen/iFollow/Krav og Design/WepAppDemo/WebAppStart.png

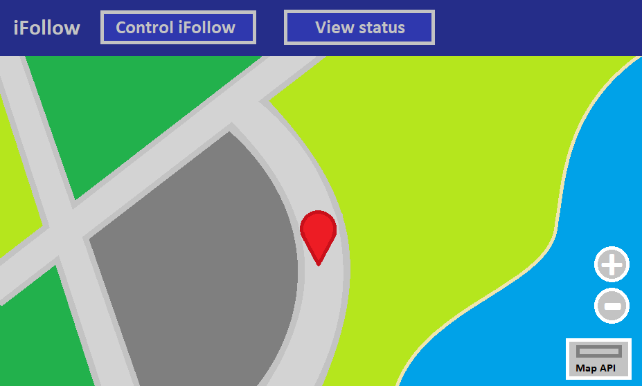
Krav og Design/WepAppDemo/WebAppStart.png
