MkLJensen/iFollow/Rapport Billeder/AktivitetsDiagram_PSOCSPI.PNG

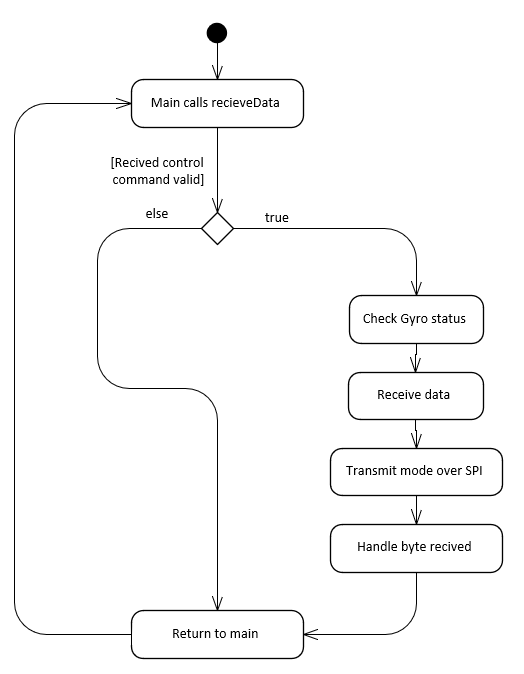
Rapport Billeder/AktivitetsDiagram_PSOCSPI.PNG
