MkLJensen/iFollow/Rapport Billeder/BlokDiagram_NoPorts.PNG

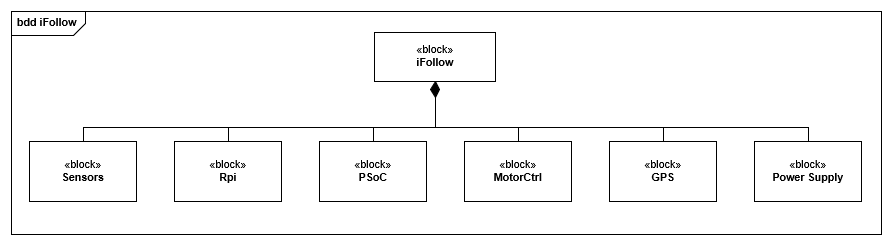
Rapport Billeder/BlokDiagram_NoPorts.PNG
