MkLJensen/iFollow/Rapport Billeder/Bodeplot_motor_reg.PNG

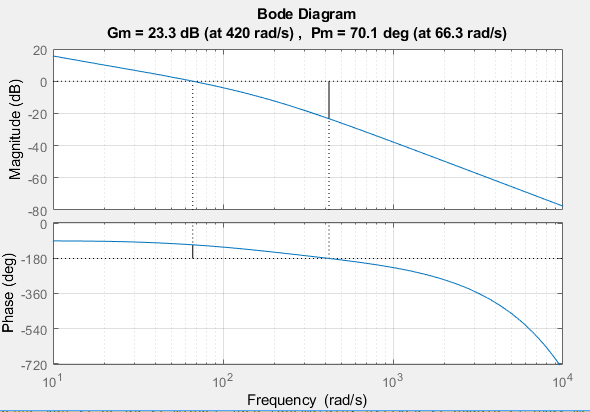
Rapport Billeder/Bodeplot_motor_reg.PNG
