MkLJensen/iFollow/Rapport Billeder/IBD_GPS.PNG

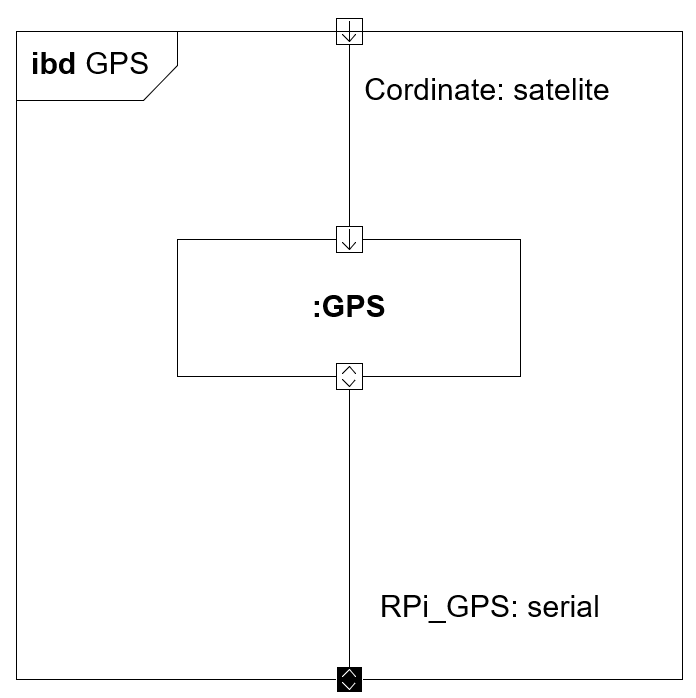
Rapport Billeder/IBD_GPS.PNG
