MkLJensen/iFollow/Rapport Billeder/IBD_motorctrl.PNG

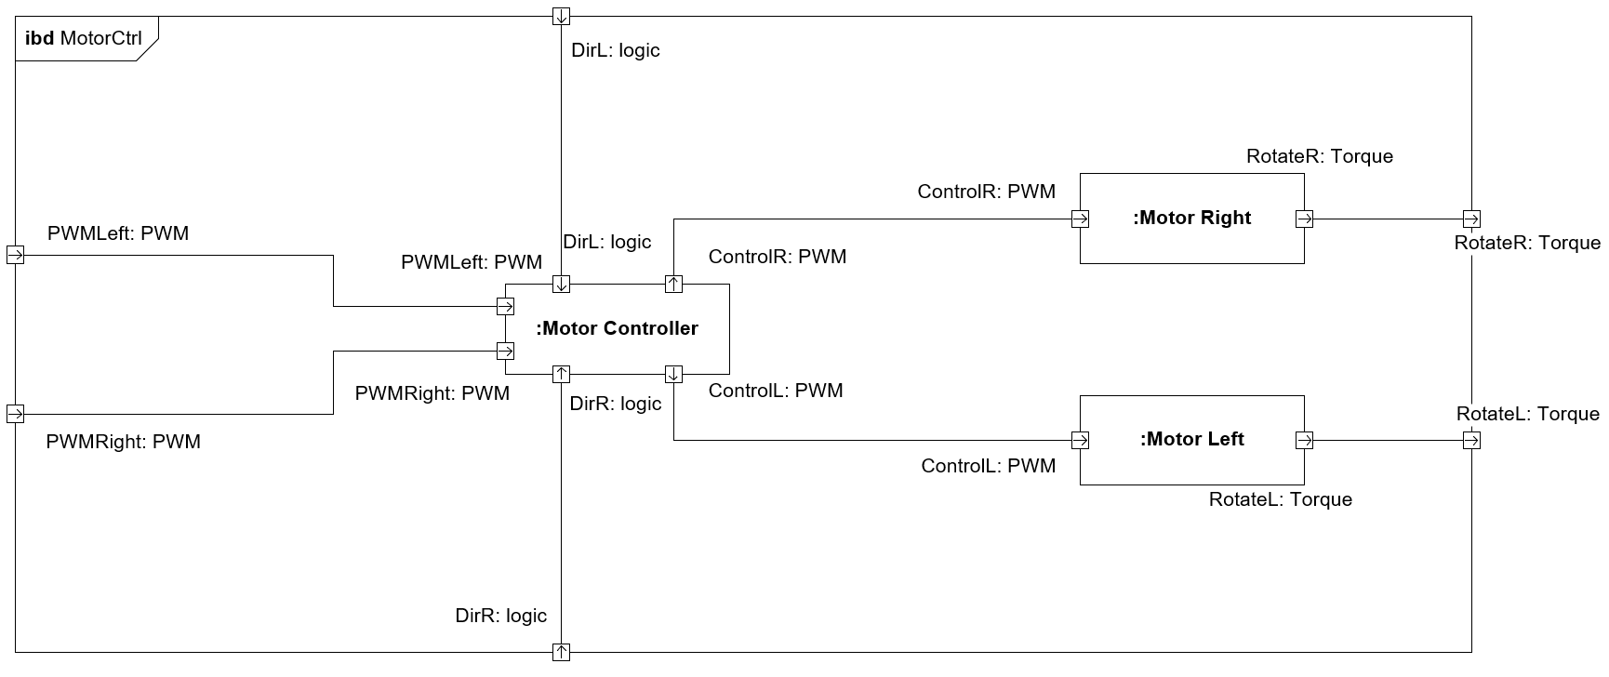
Rapport Billeder/IBD_motorctrl.PNG
