MkLJensen/iFollow/Rapport Billeder/IBD_PSoC.PNG

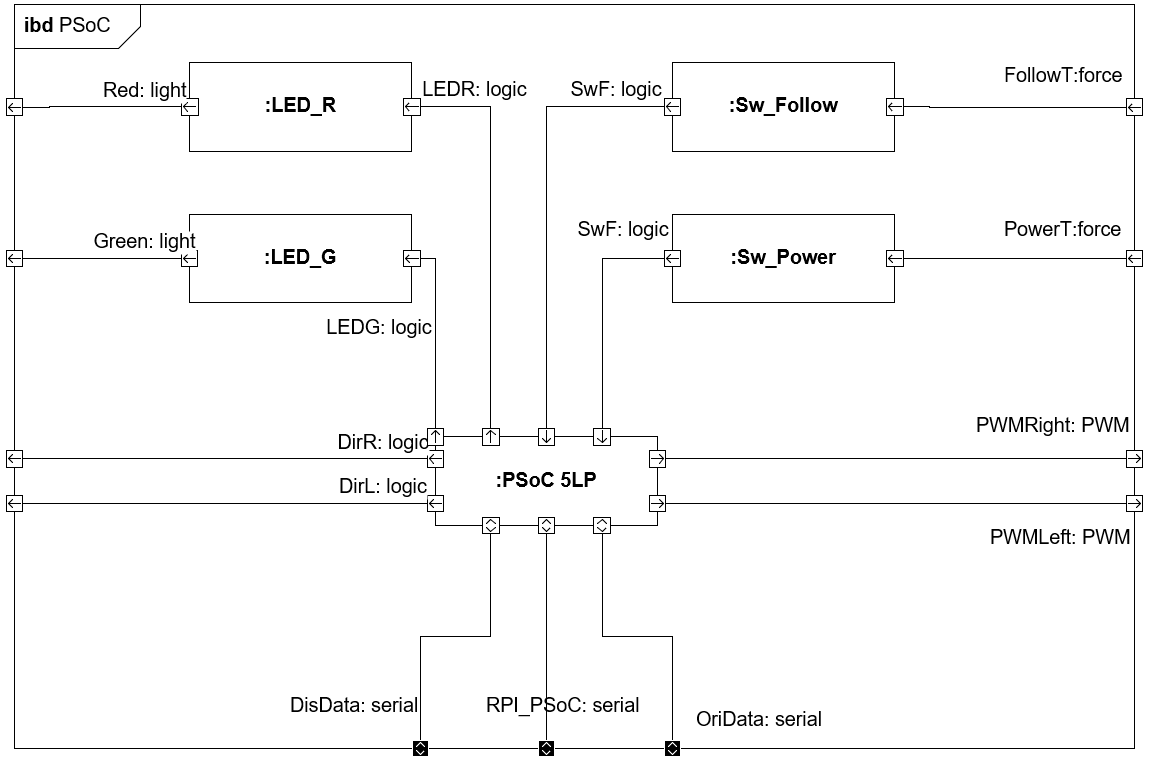
Rapport Billeder/IBD_PSoC.PNG
