MkLJensen/iFollow/Rapport Billeder/IBD_RPi.PNG

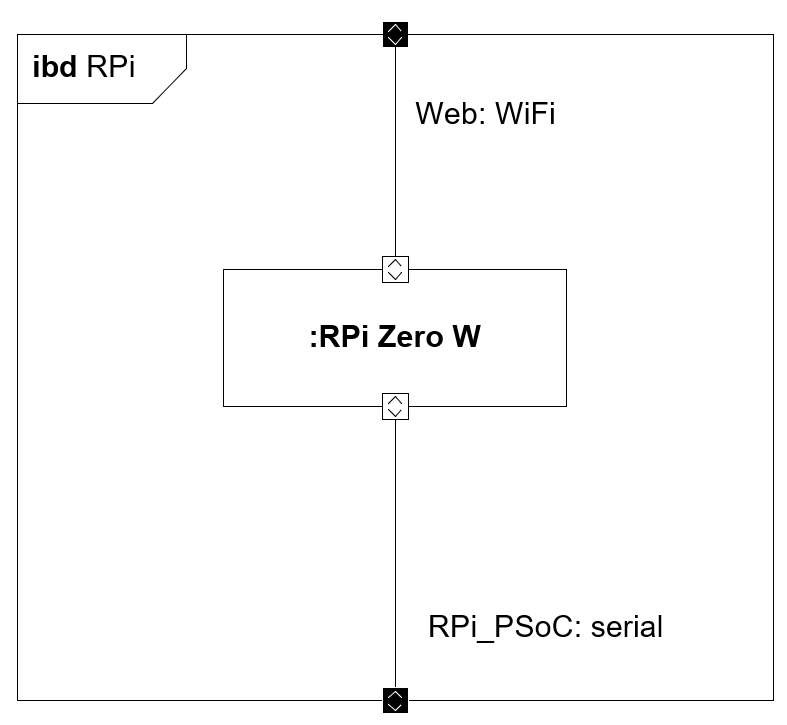
Rapport Billeder/IBD_RPi.PNG
