MkLJensen/iFollow/Rapport Billeder/IBD_Sensors.PNG

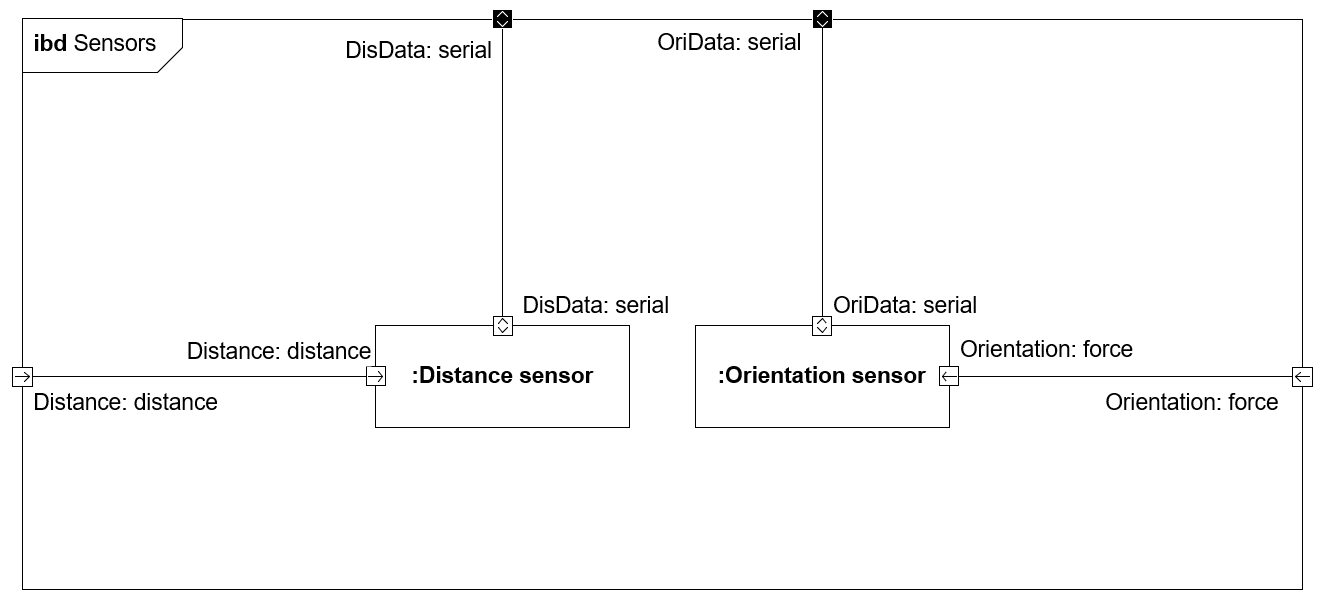
Rapport Billeder/IBD_Sensors.PNG
