MkLJensen/iFollow/Rapport Billeder/Leadreg.PNG

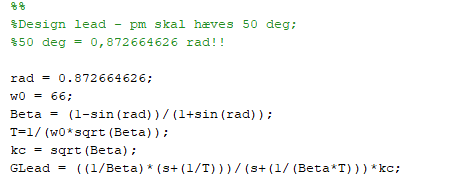
Rapport Billeder/Leadreg.PNG
