MkLJensen/iFollow/Rapport Billeder/Motor_diagram.png

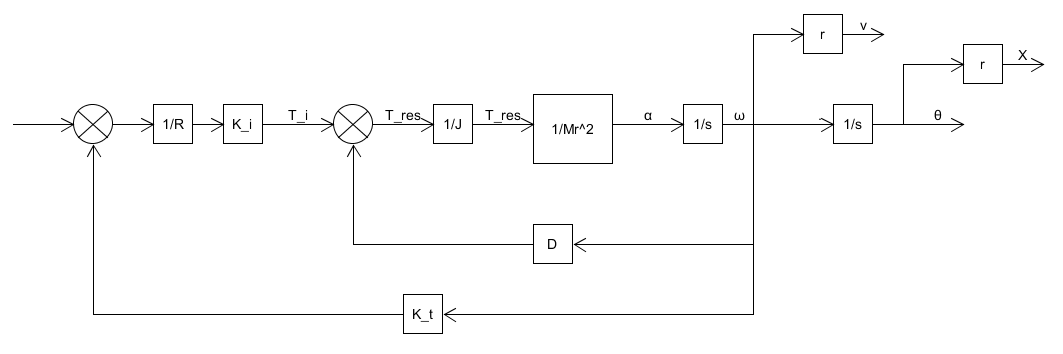
Rapport Billeder/Motor_diagram.png
