MkLJensen/iFollow/Rapport Billeder/PowerSupplyDiagram.PNG

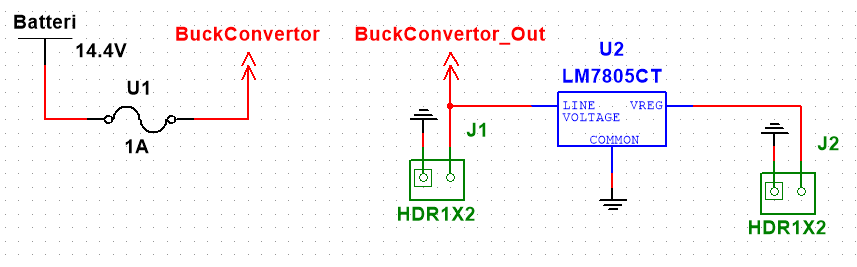
Rapport Billeder/PowerSupplyDiagram.PNG
