MkLJensen/iFollow/Rapport Billeder/PSoC arkitektur/MotorNytKlasse.PNG

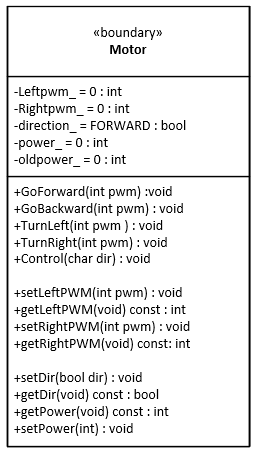
Rapport Billeder/PSoC arkitektur/MotorNytKlasse.PNG
