MkLJensen/iFollow/Rapport Billeder/PSoC arkitektur/rpiSPINytKlasse.PNG

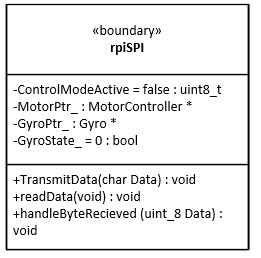
Rapport Billeder/PSoC arkitektur/rpiSPINytKlasse.PNG
