MkLJensen/iFollow/Rapport Billeder/SystemSekvensDiagram/SystemSekvensDiagram_UC1.PNG

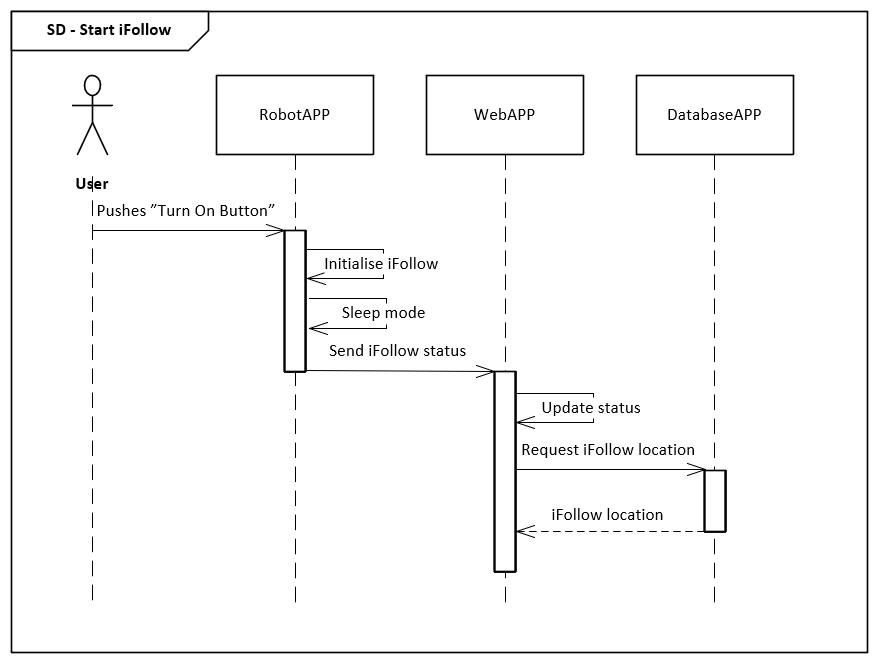
Rapport Billeder/SystemSekvensDiagram/SystemSekvensDiagram_UC1.PNG
