MkLJensen/iFollow/Rapport Billeder/SystemSekvensDiagram/SystemSekvensDiagram_UC2.PNG

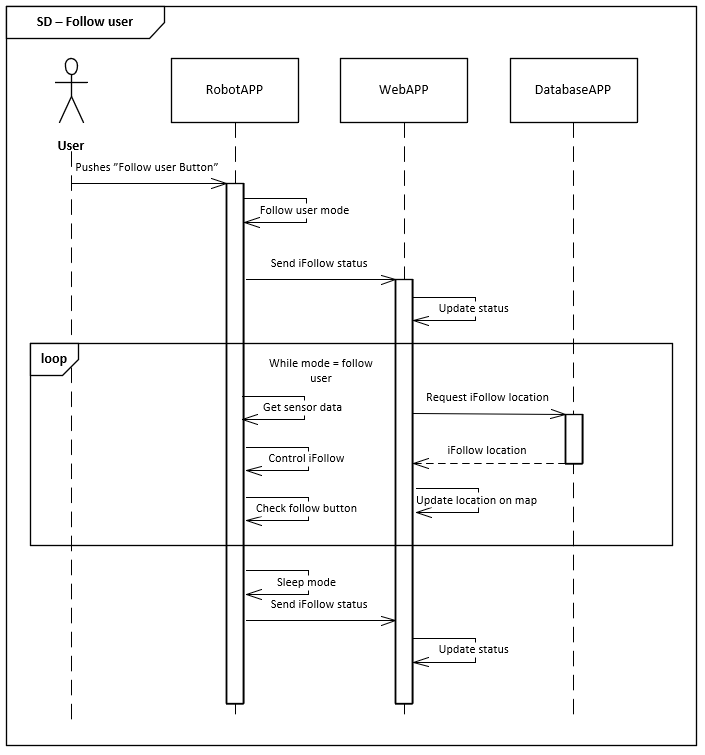
Rapport Billeder/SystemSekvensDiagram/SystemSekvensDiagram_UC2.PNG
