MkLJensen/iFollow/Rapport Billeder/SystemSekvensDiagram/SystemSekvensDiagram_UC3.PNG

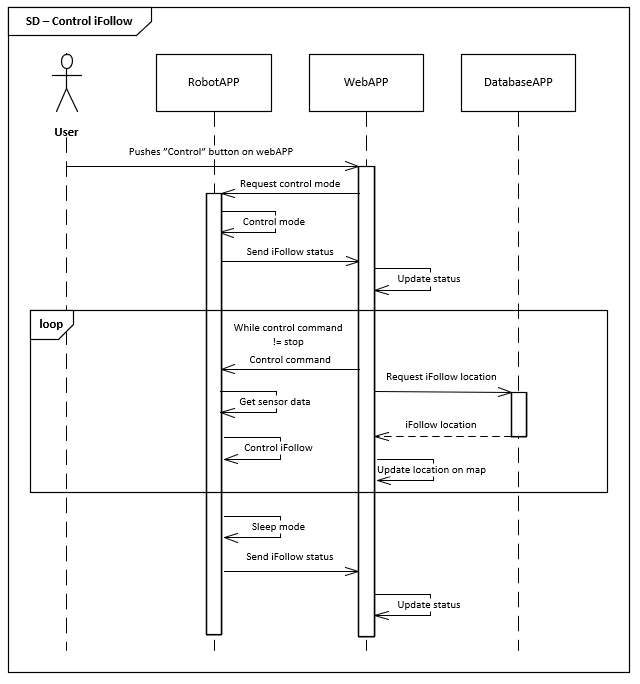
Rapport Billeder/SystemSekvensDiagram/SystemSekvensDiagram_UC3.PNG
