MkLJensen/iFollow/RapportBilag/Proces/Trello/produkt backlog.PNG

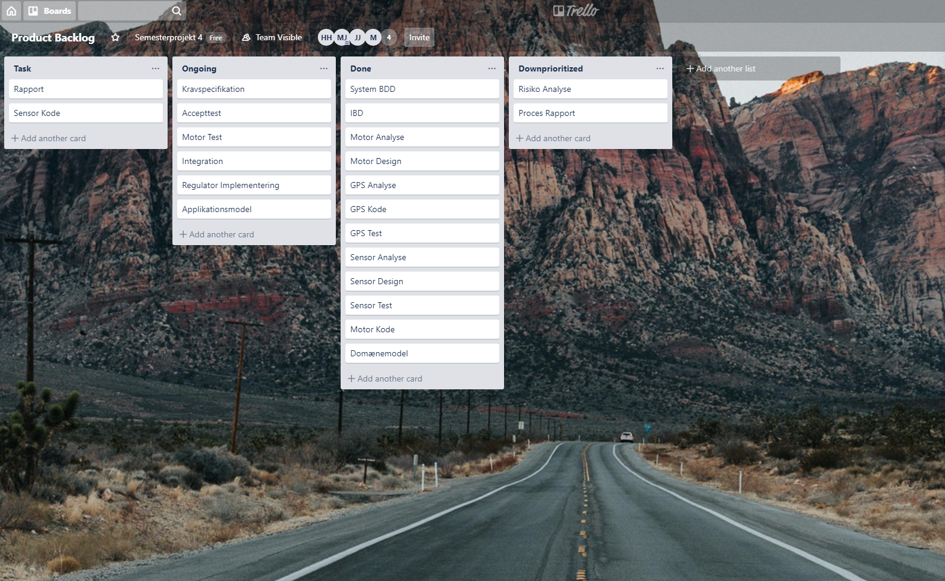
RapportBilag/Proces/Trello/produkt backlog.PNG
