MkLJensen/iFollow/RapportBilag/Proces/Trello/Sprint1.PNG

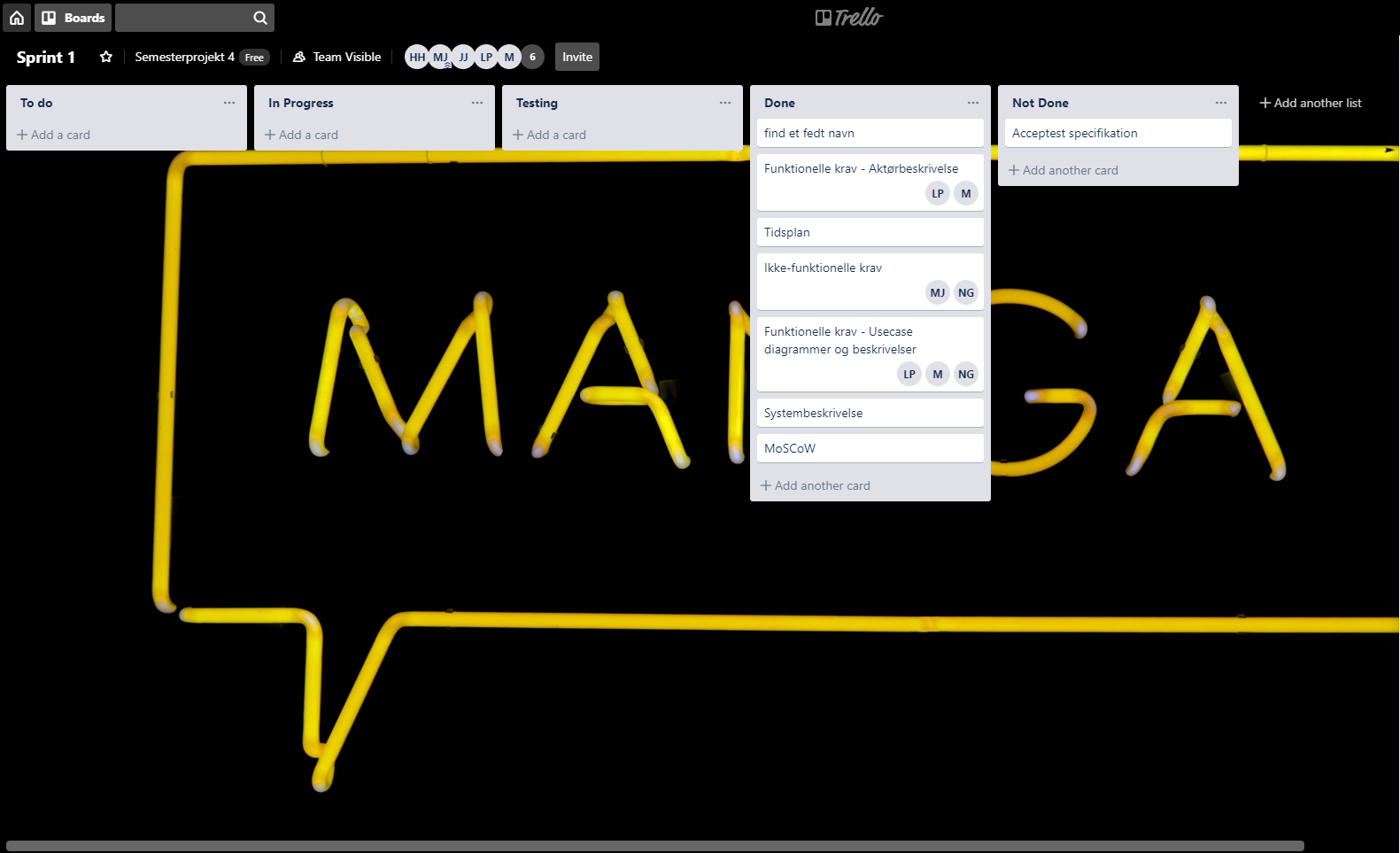
RapportBilag/Proces/Trello/Sprint1.PNG
