MkLJensen/iFollow/RapportBilag/Proces/Trello/Sprint2.PNG

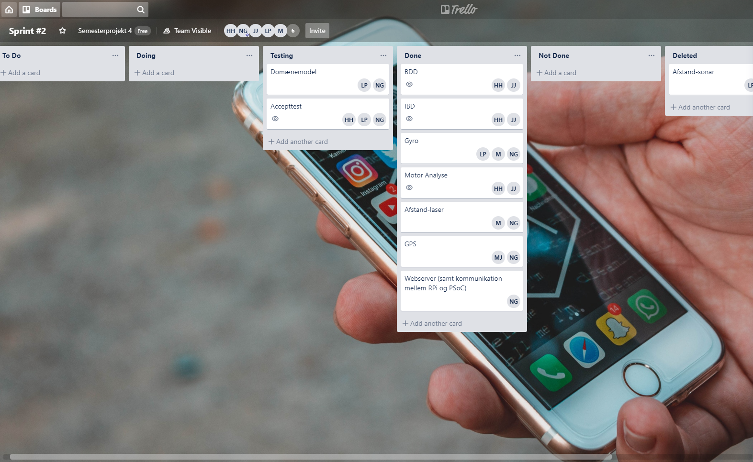
RapportBilag/Proces/Trello/Sprint2.PNG
