MkLJensen/iFollow/Software/Motorstyring/Motor_Step_Svar.png

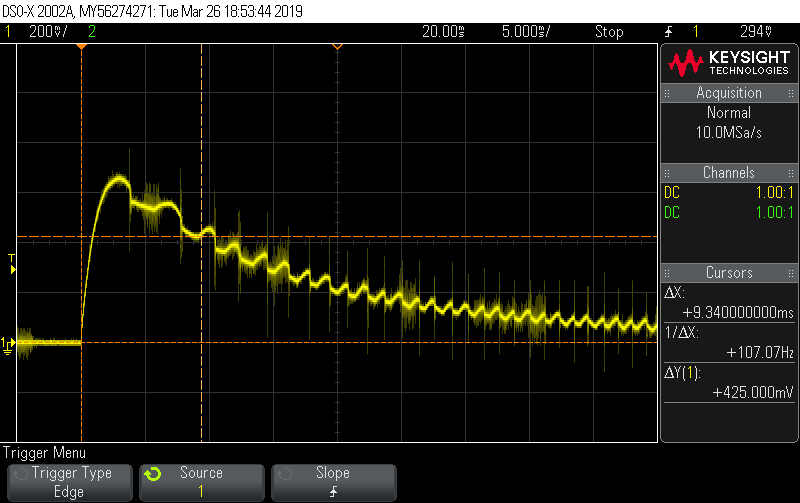
Software/Motorstyring/Motor_Step_Svar.png
