MkLJensen/iFollow/RapportBilag/Kode/Webapplikation/testwebside.html

# iFollow

LED 1 LED 2 LED 3

LED1

LED2

LED3
