MkLJensen/iFollow/Krav og Design/GyrosensorTest.png

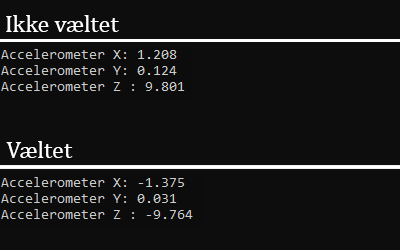
Krav og Design/GyrosensorTest.png
