MkLJensen/iFollow/Krav og Design/SPIRPi_Test.png

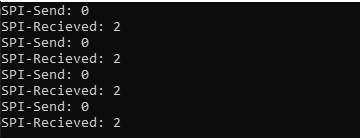
Krav og Design/SPIRPi_Test.png
