MkLJensen/iFollow/Krav og Design/TestAfWebserver.png

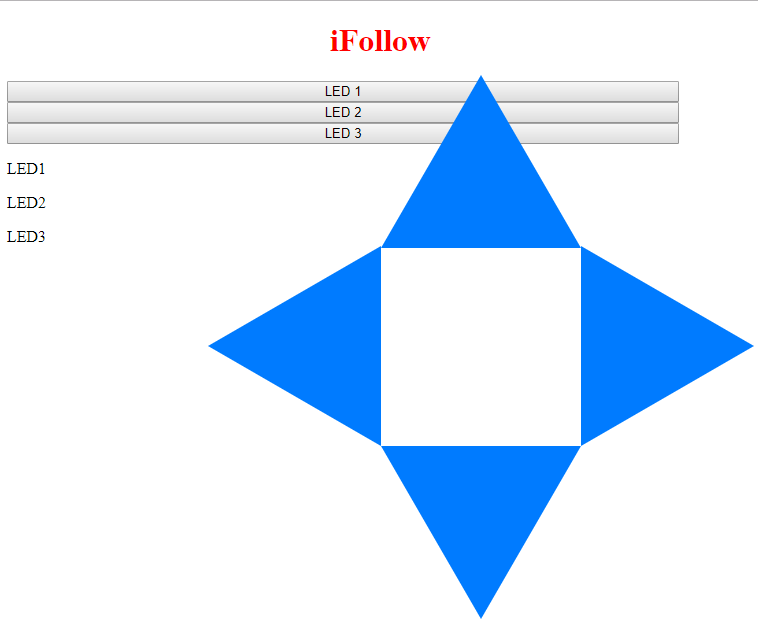
Krav og Design/TestAfWebserver.png
