MkLJensen/iFollow/Krav og Design/TestAfWebserver_oldindex.PNG

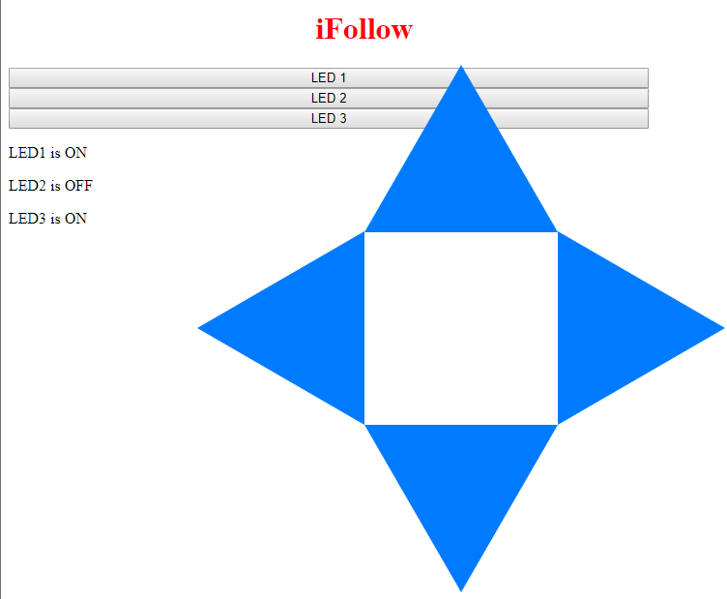
Krav og Design/TestAfWebserver_oldindex.PNG
