MkLJensen/iFollow/Rapport Billeder/HjemmesideResultat.PNG

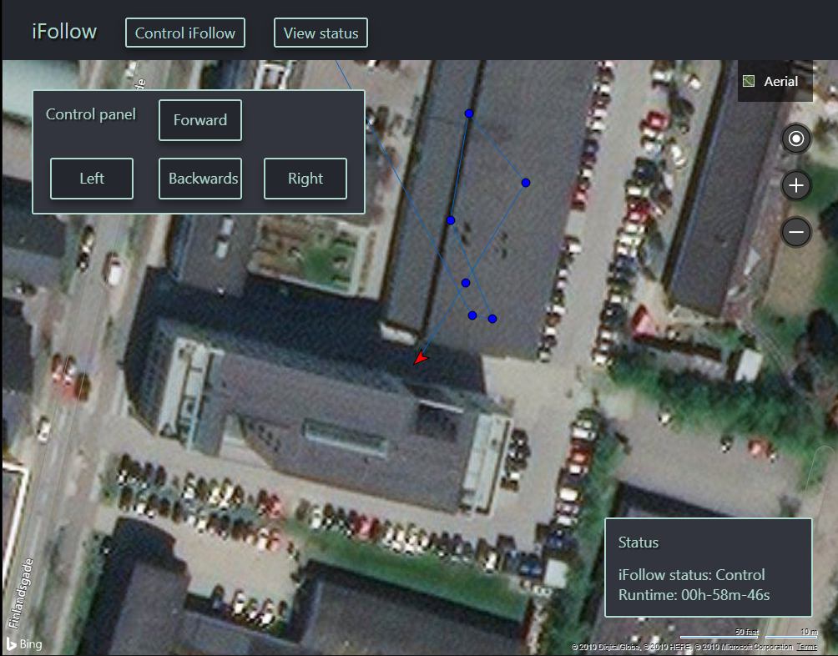
Rapport Billeder/HjemmesideResultat.PNG
