MkLJensen/iFollow/Software/Arduino/Test_1_Sensors_3.PNG

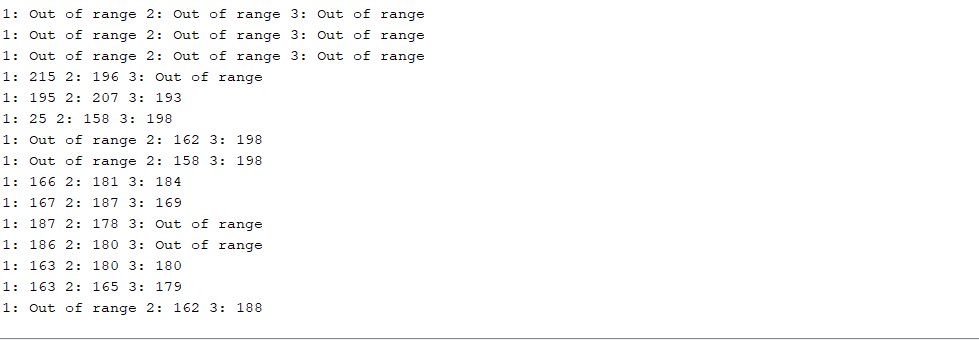
Software/Arduino/Test_1_Sensors_3.PNG
