MkLJensen/iFollow/Software/PSOC/Projekt_PSoC_Kode/Projekt_PSoC_Kode.cydsn/CortexM3/ARM_GCC_541/Debug/LINK_options.txt

-Wl,--start-group -o "C:\\Users\\jespe\\Desktop\\GIT\\iFollow\\Software\\PSOC\\Projekt_PSoC_Kode\\Projekt_PSoC_Kode.cydsn\\CortexM3\\ARM_GCC_541\\Debug\\Projekt_PSoC_Kode.elf" ".\\CortexM3\\ARM_GCC_541\\Debug\\main.o" ".\\CortexM3\\ARM_GCC_541\\Debug\\RpiSPI.o" ".\\CortexM3\\ARM_GCC_541\\Debug\\PIDcontroller.o" ".\\CortexM3\\ARM_GCC_541\\Debug\\MotorController.o" ".\\CortexM3\\ARM_GCC_541\\Debug\\Switches.o" ".\\CortexM3\\ARM_GCC_541\\Debug\\LED.o" ".\\CortexM3\\ARM_GCC_541\\Debug\\GyroDefs.o" ".\\CortexM3\\ARM_GCC_541\\Debug\\i2c.o" ".\\CortexM3\\ARM_GCC_541\\Debug\\Gyro.o" ".\\CortexM3\\ARM_GCC_541\\Debug\\ToF.o" ".\\CortexM3\\ARM_GCC_541\\Debug\\cyfitter_cfg.o" ".\\CortexM3\\ARM_GCC_541\\Debug\\cymetadata.o" ".\\CortexM3\\ARM_GCC_541\\Debug\\Cm3Start.o" ".\\CortexM3\\ARM_GCC_541\\Debug\\Projekt_PSoC_Kode.a" "C:\\Program\ Files\ (x86)\\Cypress\\PSoC\ Creator\\4.2\\PSoC\ Creator\\psoc\\content\\cycomponentlibrary\\CyComponentLibrary.cylib\\CortexM3\\ARM_GCC_541\\Debug\\CyComponentLibrary.a" -mcpu=cortex-m3 -mthumb -L "Generated_Source\\PSoC5" "-Wl,-Map,.\\CortexM3\\ARM_GCC_541\\Debug/Projekt_PSoC_Kode.map" -T "Generated_Source\\PSoC5\\cm3gcc.ld" -specs=nano.specs -Wl,--gc-sections -g -ffunction-sections -Og -ffat-lto-objects -Wl,--end-group
