MkLJensen/iFollow/Software/PSOC/Gyrosensor/GyrosensorProject.cydsn/CortexM3/ARM_GCC_541/Debug/LINK_options.txt

-Wl,--start-group -o "C:\\Users\\SYFO\\Documents\\Git\\iFollow\\Software\\PSOC\\Gyrosensor\\GyrosensorProject.cydsn\\CortexM3\\ARM_GCC_541\\Debug\\GyrosensorProject.elf" ".\\CortexM3\\ARM_GCC_541\\Debug\\main.o" ".\\CortexM3\\ARM_GCC_541\\Debug\\i2c.o" ".\\CortexM3\\ARM_GCC_541\\Debug\\Gyro.o" ".\\CortexM3\\ARM_GCC_541\\Debug\\GyroDefs.o" ".\\CortexM3\\ARM_GCC_541\\Debug\\cyfitter_cfg.o" ".\\CortexM3\\ARM_GCC_541\\Debug\\cymetadata.o" ".\\CortexM3\\ARM_GCC_541\\Debug\\Cm3Start.o" ".\\CortexM3\\ARM_GCC_541\\Debug\\GyrosensorProject.a" "C:\\Program\ Files\ (x86)\\Cypress\\PSoC\ Creator\\4.2\\PSoC\ Creator\\psoc\\content\\cycomponentlibrary\\CyComponentLibrary.cylib\\CortexM3\\ARM_GCC_541\\Debug\\CyComponentLibrary.a" -mcpu=cortex-m3 -mthumb -L "Generated_Source\\PSoC5" "-Wl,-Map,.\\CortexM3\\ARM_GCC_541\\Debug/GyrosensorProject.map" -T "Generated_Source\\PSoC5\\cm3gcc.ld" -specs=nano.specs -u _printf_float -Wl,--gc-sections -g -ffunction-sections -Og -ffat-lto-objects -Wl,--end-group
