MkLJensen/iFollow/(list of files, drawings)

Other design files:
Multisim/Ny mappe/Motor.ms14
Multisim/Ny mappe/Splitter.ms14
