MkLJensen/iFollow/Software/PSOC/ToF/Design01.cydsn/main.c

#ifdef __cplusplus
extern "C" {
#endif

    // PSoC include, this has to be wrapped
    #include "project.h"


#ifdef __cplusplus
}
#endif

#include "ToF.h"


uint8_t byteR;
ToF obj;
CY_ISR_PROTO(isr_handler)
{
   byteR = SPIS_ReadRxData();                                                             // Gemmer aflæsning af RX-buffer
   obj.handleByte(byteR);
   
}


int main(void)
{
    
    CyGlobalIntEnable; //Enable global interrupts.
    /*
    // Init
    UART_1_Start();
    UART_1_PutString("Terminal vindue er connected\n\r");
    SPIS_Start();
    isr_1_StartEx(isr_handler);

    */
    UART_1_Start();
    UART_1_PutString("Terminal vindue er connected\n\r");
    SPIS_Start();
    isr_1_StartEx(isr_handler);
    
    for(;;)
    {
        /* Place your application code here. */
        
    }

}

/* [] END OF FILE */
