MkLJensen/iFollow/Software/PSOC/Projekt_PSoC_Kode/Projekt_PSoC_Kode.cydsn/codegentemp/Motor_timer_isr.h

/*******************************************************************************
* File Name: Motor_timer_isr.h
* Version 1.70
*
*  Description:
*   Provides the function definitions for the Interrupt Controller.
*
*
********************************************************************************
* Copyright 2008-2015, Cypress Semiconductor Corporation.  All rights reserved.
* You may use this file only in accordance with the license, terms, conditions, 
* disclaimers, and limitations in the end user license agreement accompanying 
* the software package with which this file was provided.
*******************************************************************************/
#if !defined(CY_ISR_Motor_timer_isr_H)
#define CY_ISR_Motor_timer_isr_H


#include <cytypes.h>
#include <cyfitter.h>

/* Interrupt Controller API. */
void Motor_timer_isr_Start(void);
void Motor_timer_isr_StartEx(cyisraddress address);
void Motor_timer_isr_Stop(void);

CY_ISR_PROTO(Motor_timer_isr_Interrupt);

void Motor_timer_isr_SetVector(cyisraddress address);
cyisraddress Motor_timer_isr_GetVector(void);

void Motor_timer_isr_SetPriority(uint8 priority);
uint8 Motor_timer_isr_GetPriority(void);

void Motor_timer_isr_Enable(void);
uint8 Motor_timer_isr_GetState(void);
void Motor_timer_isr_Disable(void);

void Motor_timer_isr_SetPending(void);
void Motor_timer_isr_ClearPending(void);


/* Interrupt Controller Constants */

/* Address of the INTC.VECT[x] register that contains the Address of the Motor_timer_isr ISR. */
#define Motor_timer_isr_INTC_VECTOR            ((reg32 *) Motor_timer_isr__INTC_VECT)

/* Address of the Motor_timer_isr ISR priority. */
#define Motor_timer_isr_INTC_PRIOR             ((reg8 *) Motor_timer_isr__INTC_PRIOR_REG)

/* Priority of the Motor_timer_isr interrupt. */
#define Motor_timer_isr_INTC_PRIOR_NUMBER      Motor_timer_isr__INTC_PRIOR_NUM

/* Address of the INTC.SET_EN[x] byte to bit enable Motor_timer_isr interrupt. */
#define Motor_timer_isr_INTC_SET_EN            ((reg32 *) Motor_timer_isr__INTC_SET_EN_REG)

/* Address of the INTC.CLR_EN[x] register to bit clear the Motor_timer_isr interrupt. */
#define Motor_timer_isr_INTC_CLR_EN            ((reg32 *) Motor_timer_isr__INTC_CLR_EN_REG)

/* Address of the INTC.SET_PD[x] register to set the Motor_timer_isr interrupt state to pending. */
#define Motor_timer_isr_INTC_SET_PD            ((reg32 *) Motor_timer_isr__INTC_SET_PD_REG)

/* Address of the INTC.CLR_PD[x] register to clear the Motor_timer_isr interrupt. */
#define Motor_timer_isr_INTC_CLR_PD            ((reg32 *) Motor_timer_isr__INTC_CLR_PD_REG)


#endif /* CY_ISR_Motor_timer_isr_H */


/* [] END OF FILE */
