MkLJensen/iFollow/Software/PSOC/Projekt_PSoC_Kode/Projekt_PSoC_Kode.cydsn/codegentemp/MotorPWM_1_BRUN_aliases.h

/*******************************************************************************
* File Name: MotorPWM_1_BRUN.h  
* Version 2.20
*
* Description:
*  This file contains the Alias definitions for Per-Pin APIs in cypins.h. 
*  Information on using these APIs can be found in the System Reference Guide.
*
* Note:
*
********************************************************************************
* Copyright 2008-2015, Cypress Semiconductor Corporation.  All rights reserved.
* You may use this file only in accordance with the license, terms, conditions, 
* disclaimers, and limitations in the end user license agreement accompanying 
* the software package with which this file was provided.
*******************************************************************************/

#if !defined(CY_PINS_MotorPWM_1_BRUN_ALIASES_H) /* Pins MotorPWM_1_BRUN_ALIASES_H */
#define CY_PINS_MotorPWM_1_BRUN_ALIASES_H

#include "cytypes.h"
#include "cyfitter.h"


/***************************************
*              Constants        
***************************************/
#define MotorPWM_1_BRUN_0			(MotorPWM_1_BRUN__0__PC)
#define MotorPWM_1_BRUN_0_INTR	((uint16)((uint16)0x0001u << MotorPWM_1_BRUN__0__SHIFT))

#define MotorPWM_1_BRUN_INTR_ALL	 ((uint16)(MotorPWM_1_BRUN_0_INTR))

#endif /* End Pins MotorPWM_1_BRUN_ALIASES_H */


/* [] END OF FILE */
