MkLJensen/iFollow/Software/PSOC/Projekt_PSoC_Kode/Projekt_PSoC_Kode.cydsn/codegentemp/PowerButton.h

/*******************************************************************************
* File Name: PowerButton.h  
* Version 2.20
*
* Description:
*  This file contains Pin function prototypes and register defines
*
* Note:
*
********************************************************************************
* Copyright 2008-2015, Cypress Semiconductor Corporation.  All rights reserved.
* You may use this file only in accordance with the license, terms, conditions, 
* disclaimers, and limitations in the end user license agreement accompanying 
* the software package with which this file was provided.
*******************************************************************************/

#if !defined(CY_PINS_PowerButton_H) /* Pins PowerButton_H */
#define CY_PINS_PowerButton_H

#include "cytypes.h"
#include "cyfitter.h"
#include "cypins.h"
#include "PowerButton_aliases.h"

/* APIs are not generated for P15[7:6] */
#if !(CY_PSOC5A &&\
	 PowerButton__PORT == 15 && ((PowerButton__MASK & 0xC0) != 0))


/***************************************
*        Function Prototypes             
***************************************/    

/**
* \addtogroup group_general
* @{
*/
void    PowerButton_Write(uint8 value);
void    PowerButton_SetDriveMode(uint8 mode);
uint8   PowerButton_ReadDataReg(void);
uint8   PowerButton_Read(void);
void    PowerButton_SetInterruptMode(uint16 position, uint16 mode);
uint8   PowerButton_ClearInterrupt(void);
/** @} general */

/***************************************
*           API Constants        
***************************************/
/**
* \addtogroup group_constants
* @{
*/
    /** \addtogroup driveMode Drive mode constants
     * \brief Constants to be passed as "mode" parameter in the PowerButton_SetDriveMode() function.
     *  @{
     */
        #define PowerButton_DM_ALG_HIZ         PIN_DM_ALG_HIZ
        #define PowerButton_DM_DIG_HIZ         PIN_DM_DIG_HIZ
        #define PowerButton_DM_RES_UP          PIN_DM_RES_UP
        #define PowerButton_DM_RES_DWN         PIN_DM_RES_DWN
        #define PowerButton_DM_OD_LO           PIN_DM_OD_LO
        #define PowerButton_DM_OD_HI           PIN_DM_OD_HI
        #define PowerButton_DM_STRONG          PIN_DM_STRONG
        #define PowerButton_DM_RES_UPDWN       PIN_DM_RES_UPDWN
    /** @} driveMode */
/** @} group_constants */
    
/* Digital Port Constants */
#define PowerButton_MASK               PowerButton__MASK
#define PowerButton_SHIFT              PowerButton__SHIFT
#define PowerButton_WIDTH              1u

/* Interrupt constants */
#if defined(PowerButton__INTSTAT)
/**
* \addtogroup group_constants
* @{
*/
    /** \addtogroup intrMode Interrupt constants
     * \brief Constants to be passed as "mode" parameter in PowerButton_SetInterruptMode() function.
     *  @{
     */
        #define PowerButton_INTR_NONE      (uint16)(0x0000u)
        #define PowerButton_INTR_RISING    (uint16)(0x0001u)
        #define PowerButton_INTR_FALLING   (uint16)(0x0002u)
        #define PowerButton_INTR_BOTH      (uint16)(0x0003u) 
    /** @} intrMode */
/** @} group_constants */

    #define PowerButton_INTR_MASK      (0x01u) 
#endif /* (PowerButton__INTSTAT) */


/***************************************
*             Registers        
***************************************/

/* Main Port Registers */
/* Pin State */
#define PowerButton_PS                     (* (reg8 *) PowerButton__PS)
/* Data Register */
#define PowerButton_DR                     (* (reg8 *) PowerButton__DR)
/* Port Number */
#define PowerButton_PRT_NUM                (* (reg8 *) PowerButton__PRT) 
/* Connect to Analog Globals */                                                  
#define PowerButton_AG                     (* (reg8 *) PowerButton__AG)                       
/* Analog MUX bux enable */
#define PowerButton_AMUX                   (* (reg8 *) PowerButton__AMUX) 
/* Bidirectional Enable */                                                        
#define PowerButton_BIE                    (* (reg8 *) PowerButton__BIE)
/* Bit-mask for Aliased Register Access */
#define PowerButton_BIT_MASK               (* (reg8 *) PowerButton__BIT_MASK)
/* Bypass Enable */
#define PowerButton_BYP                    (* (reg8 *) PowerButton__BYP)
/* Port wide control signals */                                                   
#define PowerButton_CTL                    (* (reg8 *) PowerButton__CTL)
/* Drive Modes */
#define PowerButton_DM0                    (* (reg8 *) PowerButton__DM0) 
#define PowerButton_DM1                    (* (reg8 *) PowerButton__DM1)
#define PowerButton_DM2                    (* (reg8 *) PowerButton__DM2) 
/* Input Buffer Disable Override */
#define PowerButton_INP_DIS                (* (reg8 *) PowerButton__INP_DIS)
/* LCD Common or Segment Drive */
#define PowerButton_LCD_COM_SEG            (* (reg8 *) PowerButton__LCD_COM_SEG)
/* Enable Segment LCD */
#define PowerButton_LCD_EN                 (* (reg8 *) PowerButton__LCD_EN)
/* Slew Rate Control */
#define PowerButton_SLW                    (* (reg8 *) PowerButton__SLW)

/* DSI Port Registers */
/* Global DSI Select Register */
#define PowerButton_PRTDSI__CAPS_SEL       (* (reg8 *) PowerButton__PRTDSI__CAPS_SEL) 
/* Double Sync Enable */
#define PowerButton_PRTDSI__DBL_SYNC_IN    (* (reg8 *) PowerButton__PRTDSI__DBL_SYNC_IN) 
/* Output Enable Select Drive Strength */
#define PowerButton_PRTDSI__OE_SEL0        (* (reg8 *) PowerButton__PRTDSI__OE_SEL0) 
#define PowerButton_PRTDSI__OE_SEL1        (* (reg8 *) PowerButton__PRTDSI__OE_SEL1) 
/* Port Pin Output Select Registers */
#define PowerButton_PRTDSI__OUT_SEL0       (* (reg8 *) PowerButton__PRTDSI__OUT_SEL0) 
#define PowerButton_PRTDSI__OUT_SEL1       (* (reg8 *) PowerButton__PRTDSI__OUT_SEL1) 
/* Sync Output Enable Registers */
#define PowerButton_PRTDSI__SYNC_OUT       (* (reg8 *) PowerButton__PRTDSI__SYNC_OUT) 

/* SIO registers */
#if defined(PowerButton__SIO_CFG)
    #define PowerButton_SIO_HYST_EN        (* (reg8 *) PowerButton__SIO_HYST_EN)
    #define PowerButton_SIO_REG_HIFREQ     (* (reg8 *) PowerButton__SIO_REG_HIFREQ)
    #define PowerButton_SIO_CFG            (* (reg8 *) PowerButton__SIO_CFG)
    #define PowerButton_SIO_DIFF           (* (reg8 *) PowerButton__SIO_DIFF)
#endif /* (PowerButton__SIO_CFG) */

/* Interrupt Registers */
#if defined(PowerButton__INTSTAT)
    #define PowerButton_INTSTAT            (* (reg8 *) PowerButton__INTSTAT)
    #define PowerButton_SNAP               (* (reg8 *) PowerButton__SNAP)
    
	#define PowerButton_0_INTTYPE_REG 		(* (reg8 *) PowerButton__0__INTTYPE)
#endif /* (PowerButton__INTSTAT) */

#endif /* CY_PSOC5A... */

#endif /*  CY_PINS_PowerButton_H */


/* [] END OF FILE */
