MkLJensen/iFollow/Software/PSOC/Projekt_PSoC_Kode/Projekt_PSoC_Kode.cydsn/codegentemp/Follow_isr.h

/*******************************************************************************
* File Name: Follow_isr.h
* Version 1.70
*
*  Description:
*   Provides the function definitions for the Interrupt Controller.
*
*
********************************************************************************
* Copyright 2008-2015, Cypress Semiconductor Corporation.  All rights reserved.
* You may use this file only in accordance with the license, terms, conditions, 
* disclaimers, and limitations in the end user license agreement accompanying 
* the software package with which this file was provided.
*******************************************************************************/
#if !defined(CY_ISR_Follow_isr_H)
#define CY_ISR_Follow_isr_H


#include <cytypes.h>
#include <cyfitter.h>

/* Interrupt Controller API. */
void Follow_isr_Start(void);
void Follow_isr_StartEx(cyisraddress address);
void Follow_isr_Stop(void);

CY_ISR_PROTO(Follow_isr_Interrupt);

void Follow_isr_SetVector(cyisraddress address);
cyisraddress Follow_isr_GetVector(void);

void Follow_isr_SetPriority(uint8 priority);
uint8 Follow_isr_GetPriority(void);

void Follow_isr_Enable(void);
uint8 Follow_isr_GetState(void);
void Follow_isr_Disable(void);

void Follow_isr_SetPending(void);
void Follow_isr_ClearPending(void);


/* Interrupt Controller Constants */

/* Address of the INTC.VECT[x] register that contains the Address of the Follow_isr ISR. */
#define Follow_isr_INTC_VECTOR            ((reg32 *) Follow_isr__INTC_VECT)

/* Address of the Follow_isr ISR priority. */
#define Follow_isr_INTC_PRIOR             ((reg8 *) Follow_isr__INTC_PRIOR_REG)

/* Priority of the Follow_isr interrupt. */
#define Follow_isr_INTC_PRIOR_NUMBER      Follow_isr__INTC_PRIOR_NUM

/* Address of the INTC.SET_EN[x] byte to bit enable Follow_isr interrupt. */
#define Follow_isr_INTC_SET_EN            ((reg32 *) Follow_isr__INTC_SET_EN_REG)

/* Address of the INTC.CLR_EN[x] register to bit clear the Follow_isr interrupt. */
#define Follow_isr_INTC_CLR_EN            ((reg32 *) Follow_isr__INTC_CLR_EN_REG)

/* Address of the INTC.SET_PD[x] register to set the Follow_isr interrupt state to pending. */
#define Follow_isr_INTC_SET_PD            ((reg32 *) Follow_isr__INTC_SET_PD_REG)

/* Address of the INTC.CLR_PD[x] register to clear the Follow_isr interrupt. */
#define Follow_isr_INTC_CLR_PD            ((reg32 *) Follow_isr__INTC_CLR_PD_REG)


#endif /* CY_ISR_Follow_isr_H */


/* [] END OF FILE */
