MkLJensen/iFollow/Software/PSOC/Projekt_PSoC_Kode/Projekt_PSoC_Kode.cydsn/codegentemp/Power_isr.h

/*******************************************************************************
* File Name: Power_isr.h
* Version 1.70
*
*  Description:
*   Provides the function definitions for the Interrupt Controller.
*
*
********************************************************************************
* Copyright 2008-2015, Cypress Semiconductor Corporation.  All rights reserved.
* You may use this file only in accordance with the license, terms, conditions, 
* disclaimers, and limitations in the end user license agreement accompanying 
* the software package with which this file was provided.
*******************************************************************************/
#if !defined(CY_ISR_Power_isr_H)
#define CY_ISR_Power_isr_H


#include <cytypes.h>
#include <cyfitter.h>

/* Interrupt Controller API. */
void Power_isr_Start(void);
void Power_isr_StartEx(cyisraddress address);
void Power_isr_Stop(void);

CY_ISR_PROTO(Power_isr_Interrupt);

void Power_isr_SetVector(cyisraddress address);
cyisraddress Power_isr_GetVector(void);

void Power_isr_SetPriority(uint8 priority);
uint8 Power_isr_GetPriority(void);

void Power_isr_Enable(void);
uint8 Power_isr_GetState(void);
void Power_isr_Disable(void);

void Power_isr_SetPending(void);
void Power_isr_ClearPending(void);


/* Interrupt Controller Constants */

/* Address of the INTC.VECT[x] register that contains the Address of the Power_isr ISR. */
#define Power_isr_INTC_VECTOR            ((reg32 *) Power_isr__INTC_VECT)

/* Address of the Power_isr ISR priority. */
#define Power_isr_INTC_PRIOR             ((reg8 *) Power_isr__INTC_PRIOR_REG)

/* Priority of the Power_isr interrupt. */
#define Power_isr_INTC_PRIOR_NUMBER      Power_isr__INTC_PRIOR_NUM

/* Address of the INTC.SET_EN[x] byte to bit enable Power_isr interrupt. */
#define Power_isr_INTC_SET_EN            ((reg32 *) Power_isr__INTC_SET_EN_REG)

/* Address of the INTC.CLR_EN[x] register to bit clear the Power_isr interrupt. */
#define Power_isr_INTC_CLR_EN            ((reg32 *) Power_isr__INTC_CLR_EN_REG)

/* Address of the INTC.SET_PD[x] register to set the Power_isr interrupt state to pending. */
#define Power_isr_INTC_SET_PD            ((reg32 *) Power_isr__INTC_SET_PD_REG)

/* Address of the INTC.CLR_PD[x] register to clear the Power_isr interrupt. */
#define Power_isr_INTC_CLR_PD            ((reg32 *) Power_isr__INTC_CLR_PD_REG)


#endif /* CY_ISR_Power_isr_H */


/* [] END OF FILE */
