MkLJensen/iFollow/(commit log)

2019-02-27 Create Use Case Diagram.vsdx
    Første udkast til iFollow Use Case Diagram 20190227
2019-03-11 Tilføjet Rigt Billede
    Et powerpoint dokument til evt. rettelser, og et .png til anvendelse i krav/rapport mm.
2019-03-12 Made dedicated directory for Software with appropriate subdirectories. Created PSoC-Driver for Gyrosensor (MPU6050).
    [GyrosensorProject.sdf]
2019-03-13 Added support for accelerometer and temperature readings
    [GyrosensorProject.sdf]
2019-03-14 Finished PSoC-driver for MB1202 / Sonarsensor
    [SonarSensor.sdf]
2019-03-18 Create ~$$Arkitektur_BDD_IBD.~vsdx
    Oprettede Mekanik Kasse til Motorer
2019-03-18 Edit Tidsplan
    [Tidsplan.xlsx]
2019-03-27 Made template for motorcontrol model in MATLAB
2019-04-03 Started working on porting Lasersensor API to PSoC, needs testing..
    [LaserDriver.sdf]
2019-04-08 MindstormPID tilføjet med kodeeksempel på PID implementering
    [LaserDriver.sdf]
2019-04-08 Added Multisim filer
    [Motor.ms14, Splitter.ms14]
2019-04-15 Added Arduino SPI-handling
2019-04-15 Software System SD diagrammer
    [LaserDriver.sdf]
2019-04-16 Added PSoC Code
    [Projekt_PSoC_Kode.sdf]
2019-04-16 Added Class Diagram for Sensor
2019-04-16 opdateret LED funktioner
2019-04-16 Added PSoC Classes
    [Projekt_PSoC_Kode.sdf]
2019-04-16 Finished Arduino SPI functionality
2019-04-17 PSoC Main edit
    [Projekt_PSoC_Kode.sdf]
2019-04-18 Edit Main
    [Projekt_PSoC_Kode.sdf]
2019-04-23 Update Motor.m
    opdateret med Z-transformering af overføringsfunktion
2019-04-23 Edit MOtor Code
    [LaserDriver.sdf, Projekt_PSoC_Kode.sdf]
2019-04-25 Opdateret til nyeste regulator specifikationer
    Opdateret med Ts og en fjernelse af Lag regulator.
2019-04-30 Packed gyro-driver into cpp class, needs testing on PSoCgit add -A
    [GyrosensorProject.sdf]
2019-05-01 Test went well with Gyro sensor, added function for getting fallen status
2019-05-09 Tilføjede motorstyring diagram og billede
2019-05-14 edit main PSoC Prog
    [Projekt_PSoC_Kode.sdf]
2019-05-20 Added pictures
    [Splitter.ms14]
2019-05-20 Opdateret motorligning og udregning
2019-05-20 Opdateret motor udregning samt indsættelse af flere referencer
2019-05-20 Added I2C_Class.png
2019-05-20 Added I2C_Class_Noborder.png
2019-05-20 Added I2C_WriteByte_SD.png
2019-05-21 Added I2C_ReadBytes_SD.png
2019-05-21 Added Motor_Class.png
2019-05-21 Added Gyro_Class.png
2019-05-21 Added comments to Gyro.c
2019-05-27 Fix Regulator
    [Projekt_PSoC_Kode.sdf]
2019-05-28 Added bilag
    [Projekt_PSoC_Kode.sdf]
2019-05-28 Arduino i bilag
